nsec/badge-conf-2023/doc/atmega328p-pins.jpeg

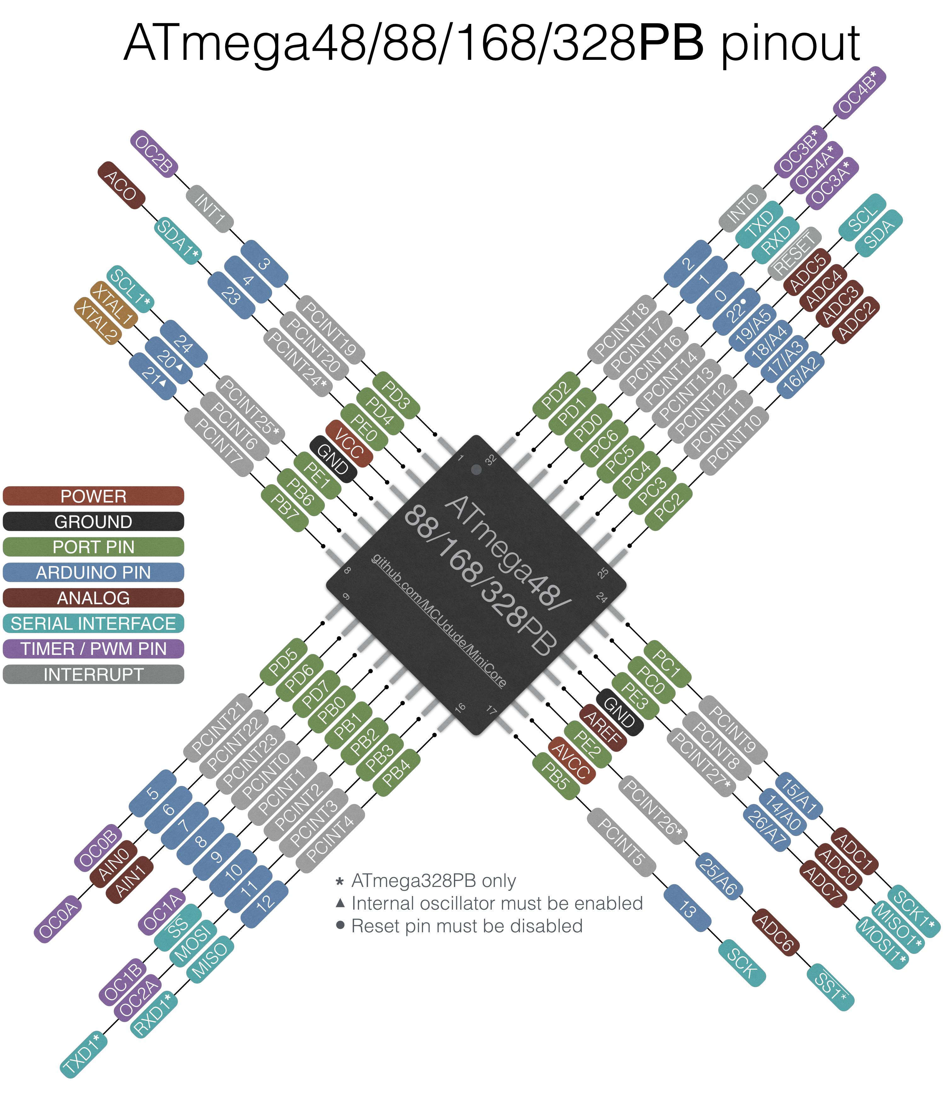
doc/atmega328p-pins.jpeg
