nsec/badge-conf-2023/PCB/badge-conference/gerbers/BOM.xlsx

Value | Designator | Footprint | JLCPCB | DIGIKEY | Comment2
0.1uF | C1, C2, C3, C4, C5, C6, C7, C8, C9, C10, C11, C12, C13, C14, C15, C16, C17, C18, C19, C20 | 0603-CAP | C14663
100K | R7 | 0603-NO | C25803
10K | R2, R8, R9, R16, R17, R18, R19 | 0603-RES | C25804
10uF | C27 | 0805-NO | C440198
1uF | C21, C26 | 0603-NO | C15849
24792479PCB_37P49X52P63_KEY | U6 | 2479PCB_37P49X52P63_KEY |  | 36-2479-ND
330 | R6 | 0603-RES | C23138
5.1K | R1, R5, R13, R14 | 0603-NO | C23186
8/16/20MHz | Q1 | RESONATOR-SMD-1:1 | C22549
AP2112-3.3 | U2 | SOT23-5 | C150742
ATMEGA328PB-AU | U1 | TQFP32-08 | C132230
CH340C | U7 | SOIC127P600X180-16N | C84681
Button | S6, S2, S3, S5, S7, S4 | TACTILE_SWITCH_SMD_5.2MM | C318884
MBR120 | D3, D4 | SOD-123 | C130880
NC | D6, D7 | CHIPLED_0805_NOOUTLINE |  |  | not connected
NC | LED2, LED3 | LED3MM |  |  | not connected
NC | LED7, LED8 | CHIPLED_1206 |  |  | not connected
NC | R3, R4 | 0207/10 |  |  | not connected
NC | R10, R11 | R1206W |  |  | not connected
NC | R12, R15 | 0603-NO |  |  | not connected
OLED | SV3 | MA04-1 |  |  | not connected
PCM12SMTRPCM12SMTR_CNK | U5 | PCM12SMTR_CNK |  | 401-2016-2-ND
RED | D1, D2, D5 | CHIPLED_0805_NOOUTLINE | C84256
RST | S1 | TACTILE_SWITCH_SMD_5.2MM |  |  | not connected
SMF05CT1G | U8 | SOT65P210X110-6N | C558443
SSW-103-22-F-D-VS-K-TRCON3_SSW-D-DUMZ_HDR_SAI | J2 | CON_3x2_FEMALE |  | S5712-ND |  | <<<updated
SYNCIN | SV2 | FE05W |  | 2057-PH1RB-05-UA-ND
SYNCOUT | SV1 | FE05W |  | S5441-ND
TYPE-C-31-M-12 | J3 | HRO_TYPE-C-31-M-12 | C165948
WS2812-2020 | U3, U4, U9, U10, U11, U12, U13, U14, U15, U16, U17, U18, U19, U20, U21, U22 | LED_WS2812-2020 | C965555
SSW-103-22-F-D-VS-K-TRCON3_SSW-D-DUMZ_HDR_SAI | J1 | CON_3x2_MALE |  | 2073-BG050-06A-0-0450-0737-0350-L-D-ND |  | <<<updated
