nsec/badge-conf-2023/PCB/badge-conference/pdf/schematic.pdf

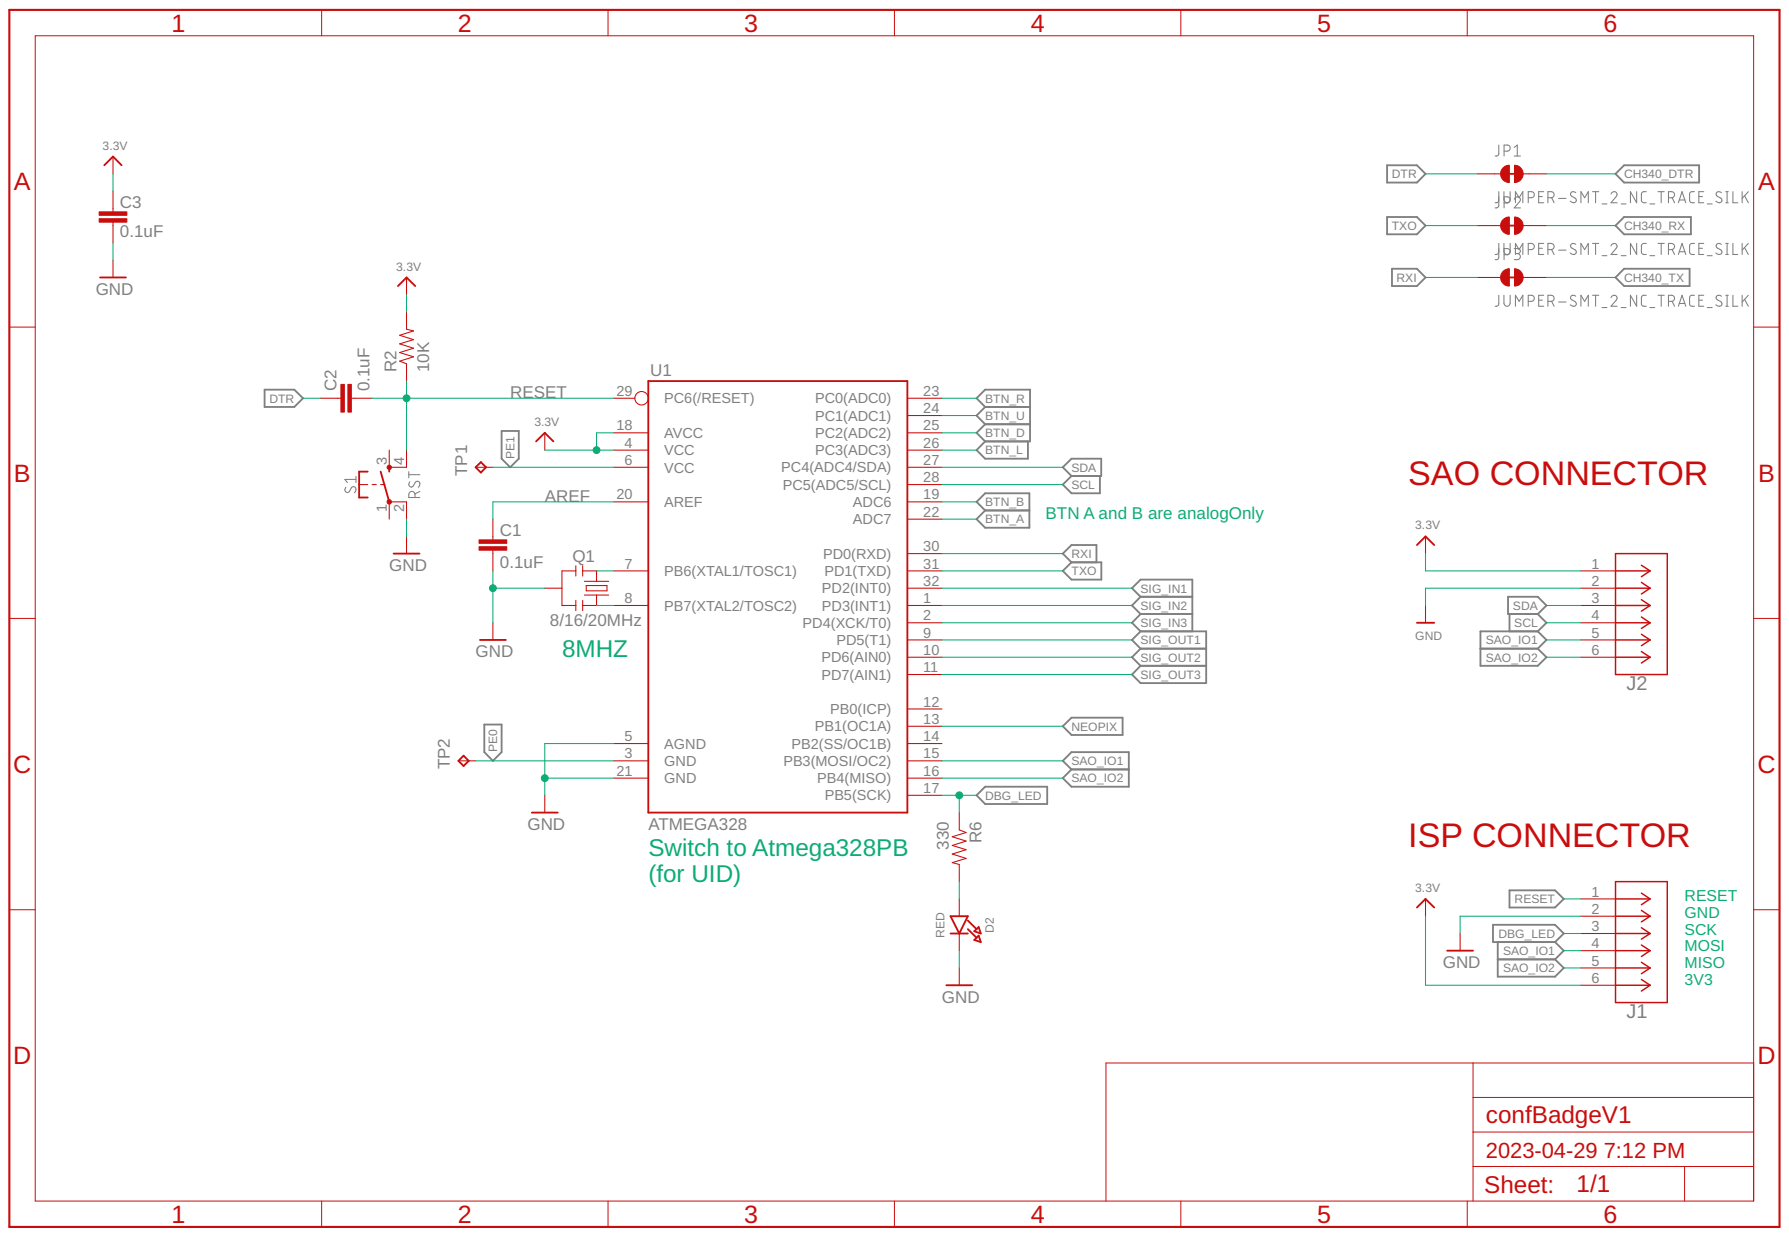
[picture p2: page 1]

SDA
SCL
BTN A and B are analogOnly

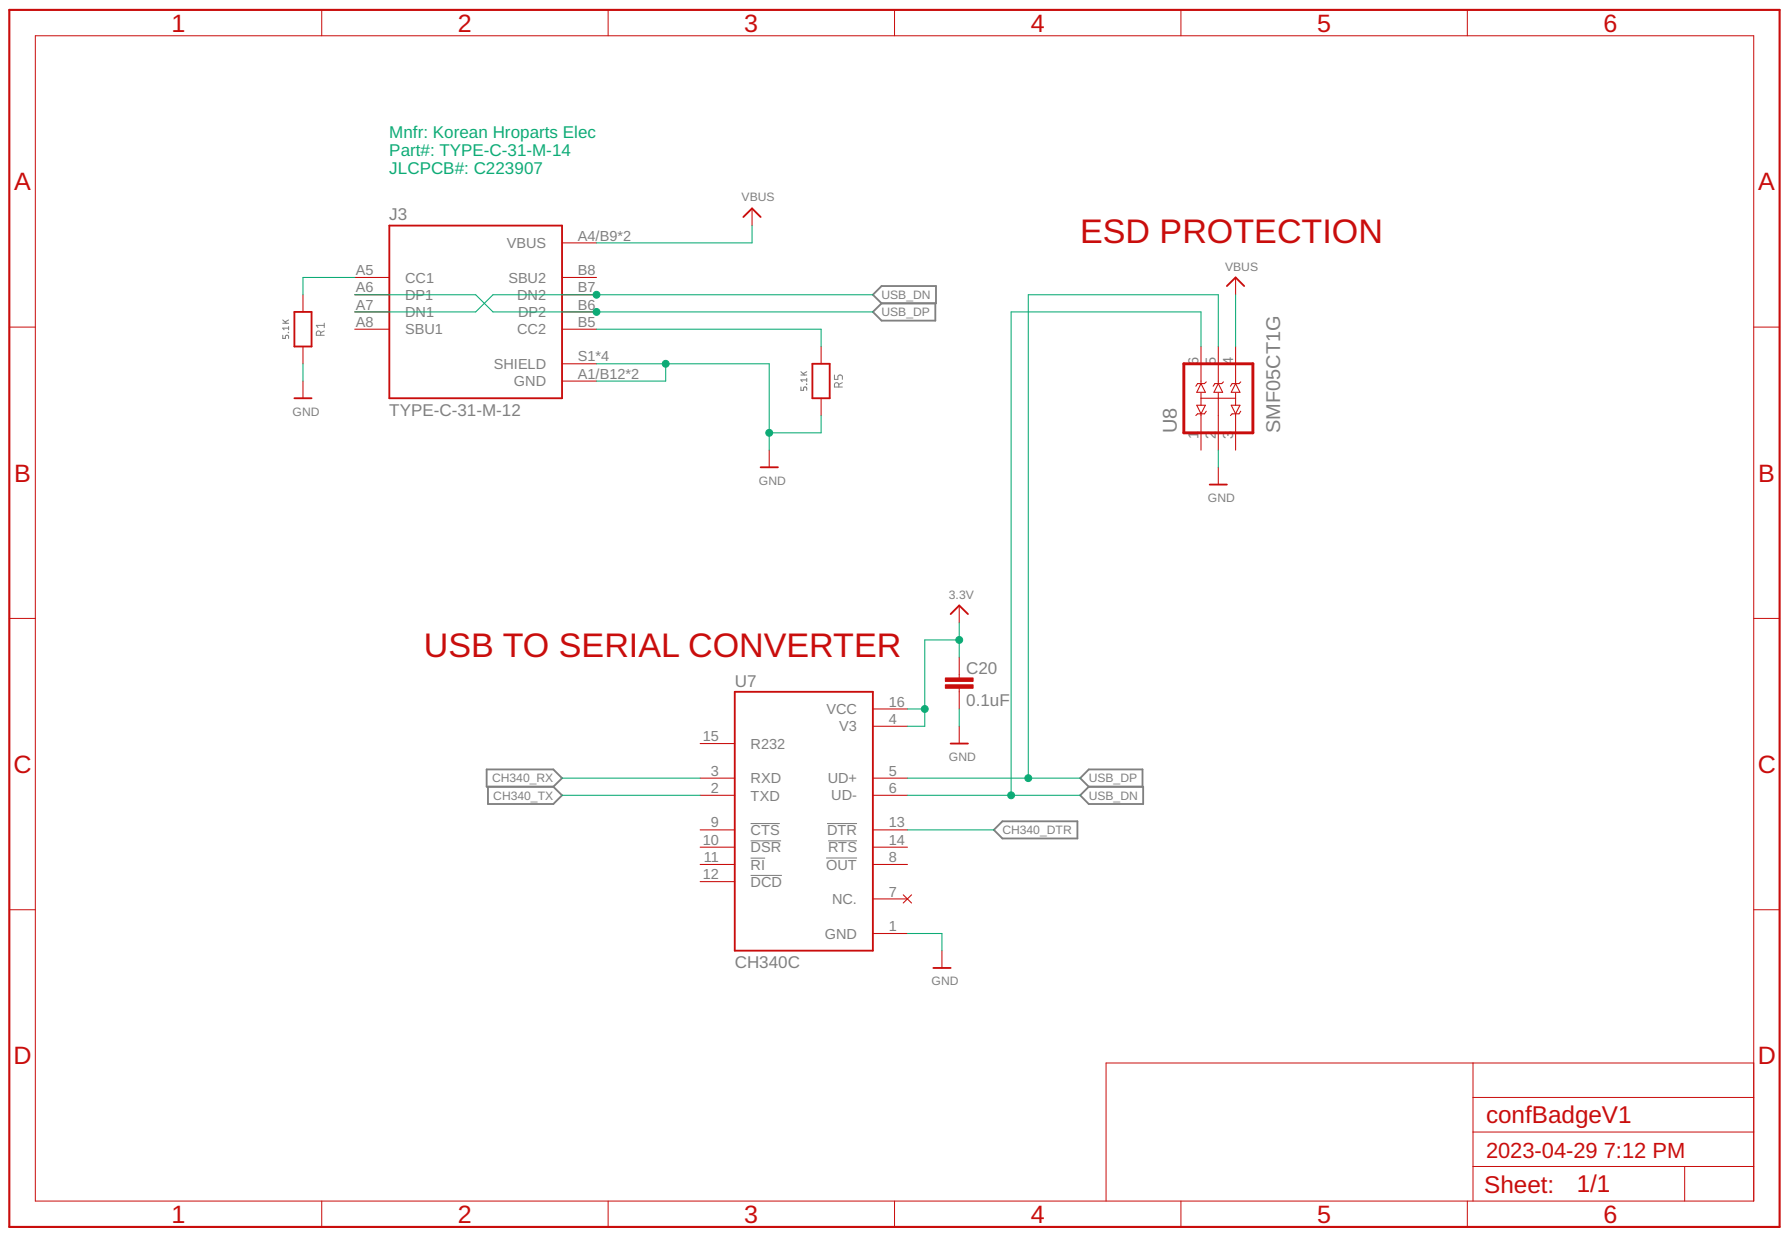
[picture p3: page 2]

Mnfr: Korean Hroparts Elec Part#: TYPE-C-31-M-14

USB TO SERIAL CONVERTER

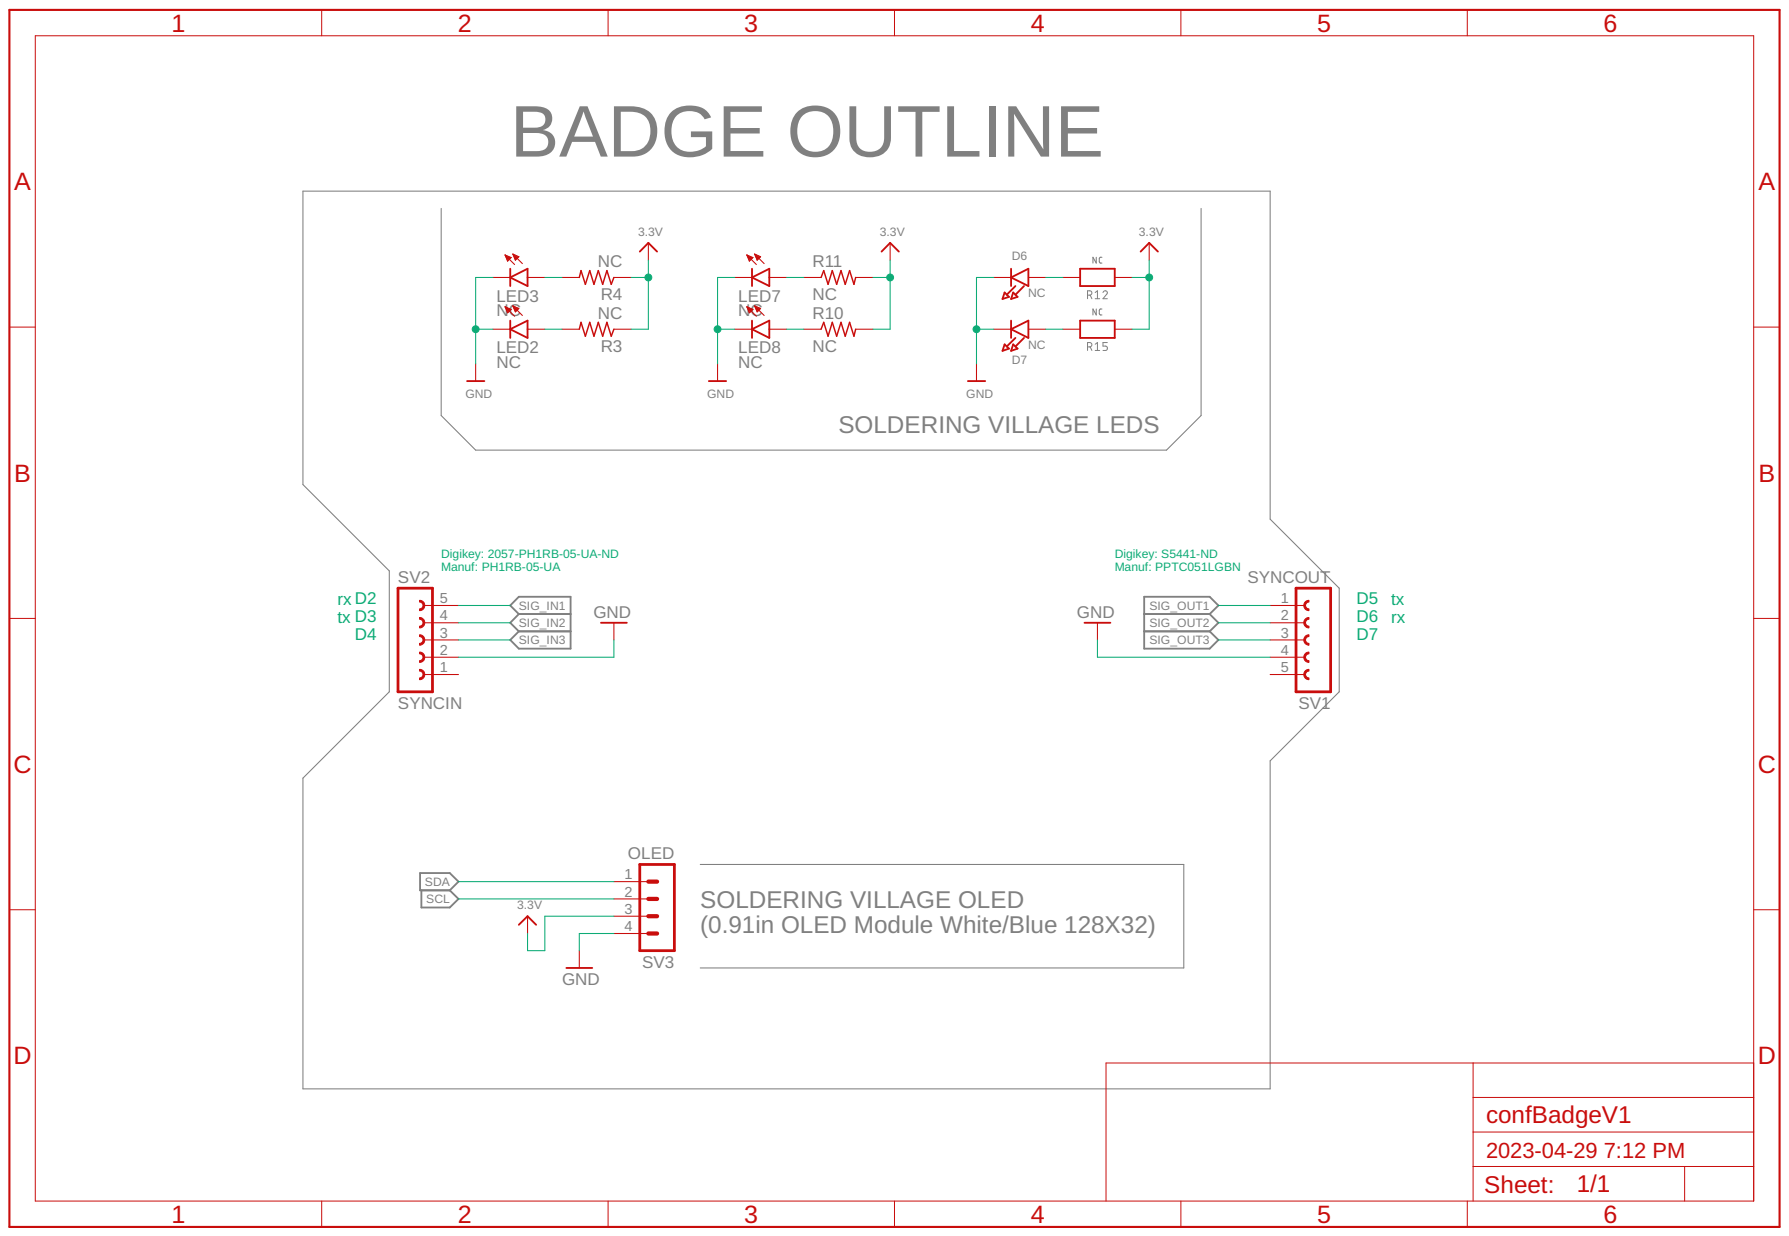
[picture p4: page 3]

SOLDERING VILLAGE OLED
(0.91in OLED Module White/Blue 128X32)

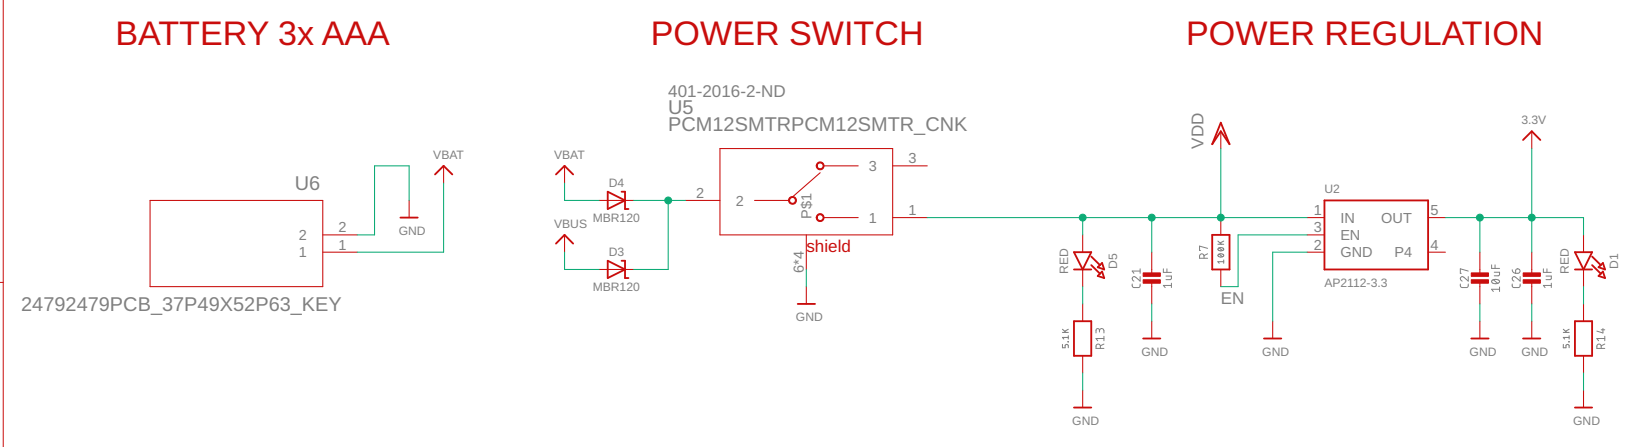
[picture p5: page 4]

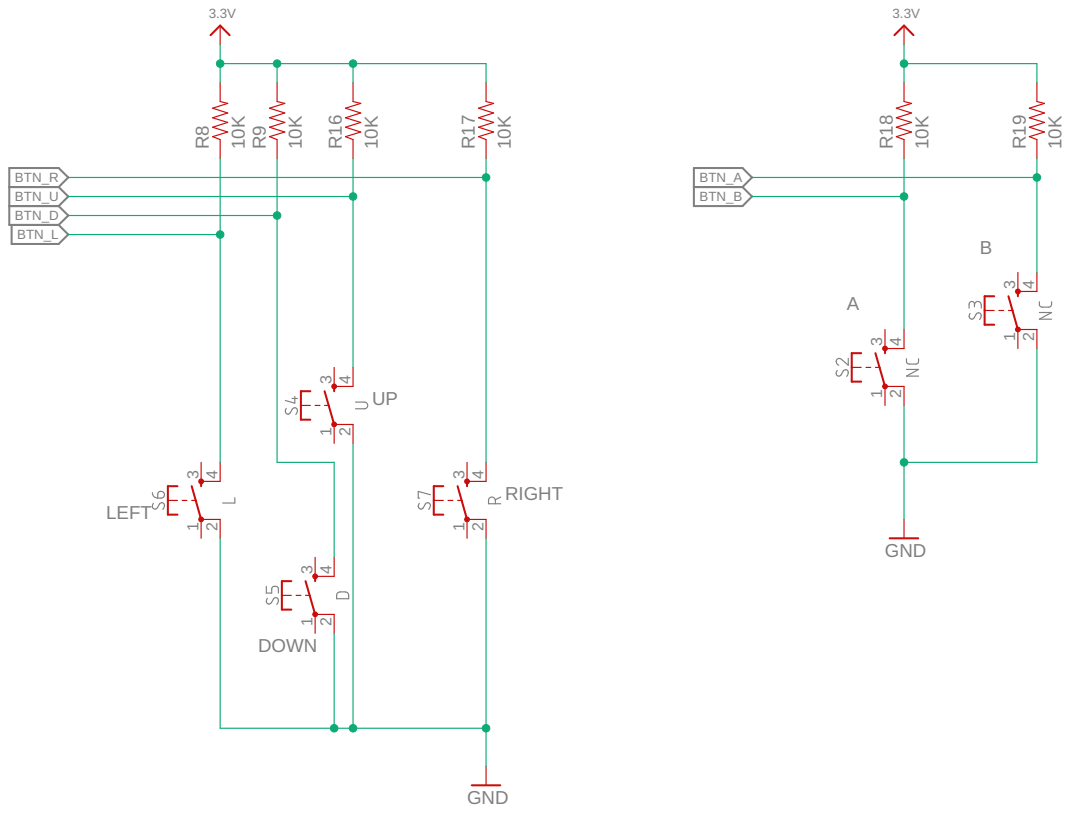
[picture p6: page 5]

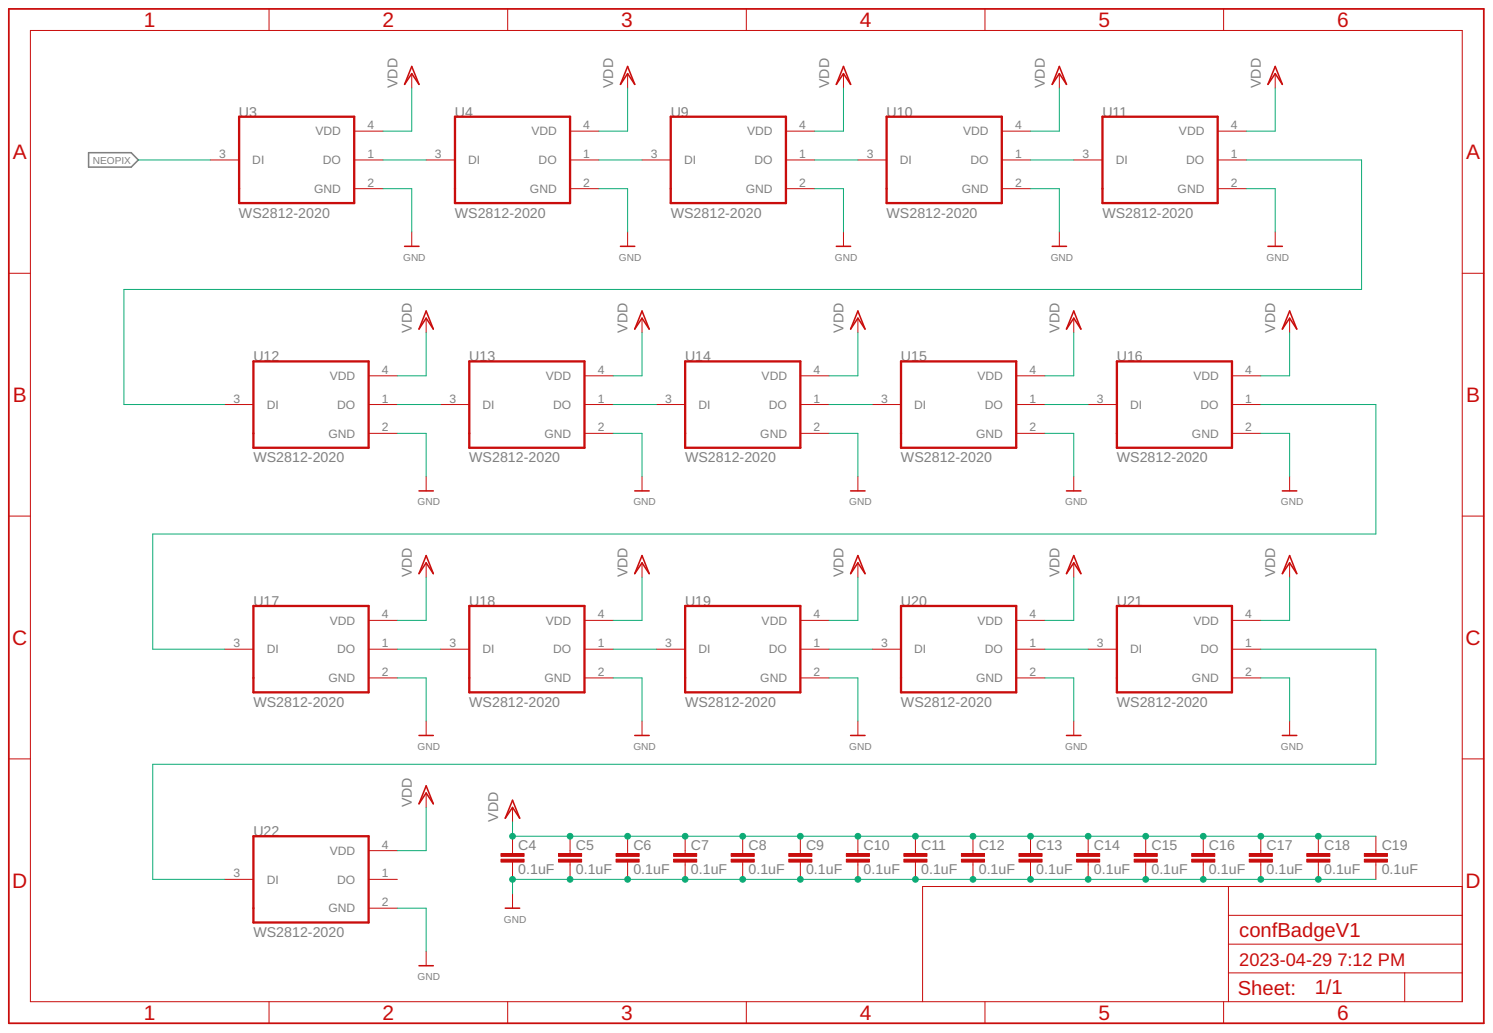
[picture p7: page 6]
