nsec/badge-conf-2023/PCB/badge-conference/pdf/pcbLayout.pdf

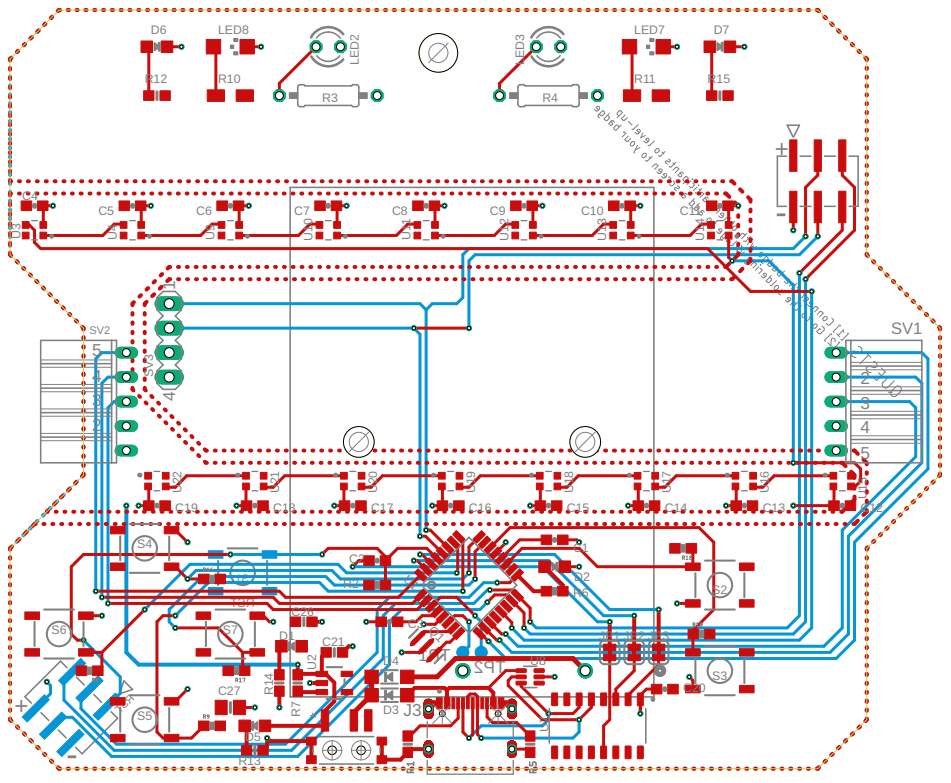
[picture p8: page 1]
