nsec/badge-conf-2023/PCB/badge-conference/confBadgeV1.brd

## EAGLE design PCB/badge-conference/confBadgeV1.brd (2023-05-26)

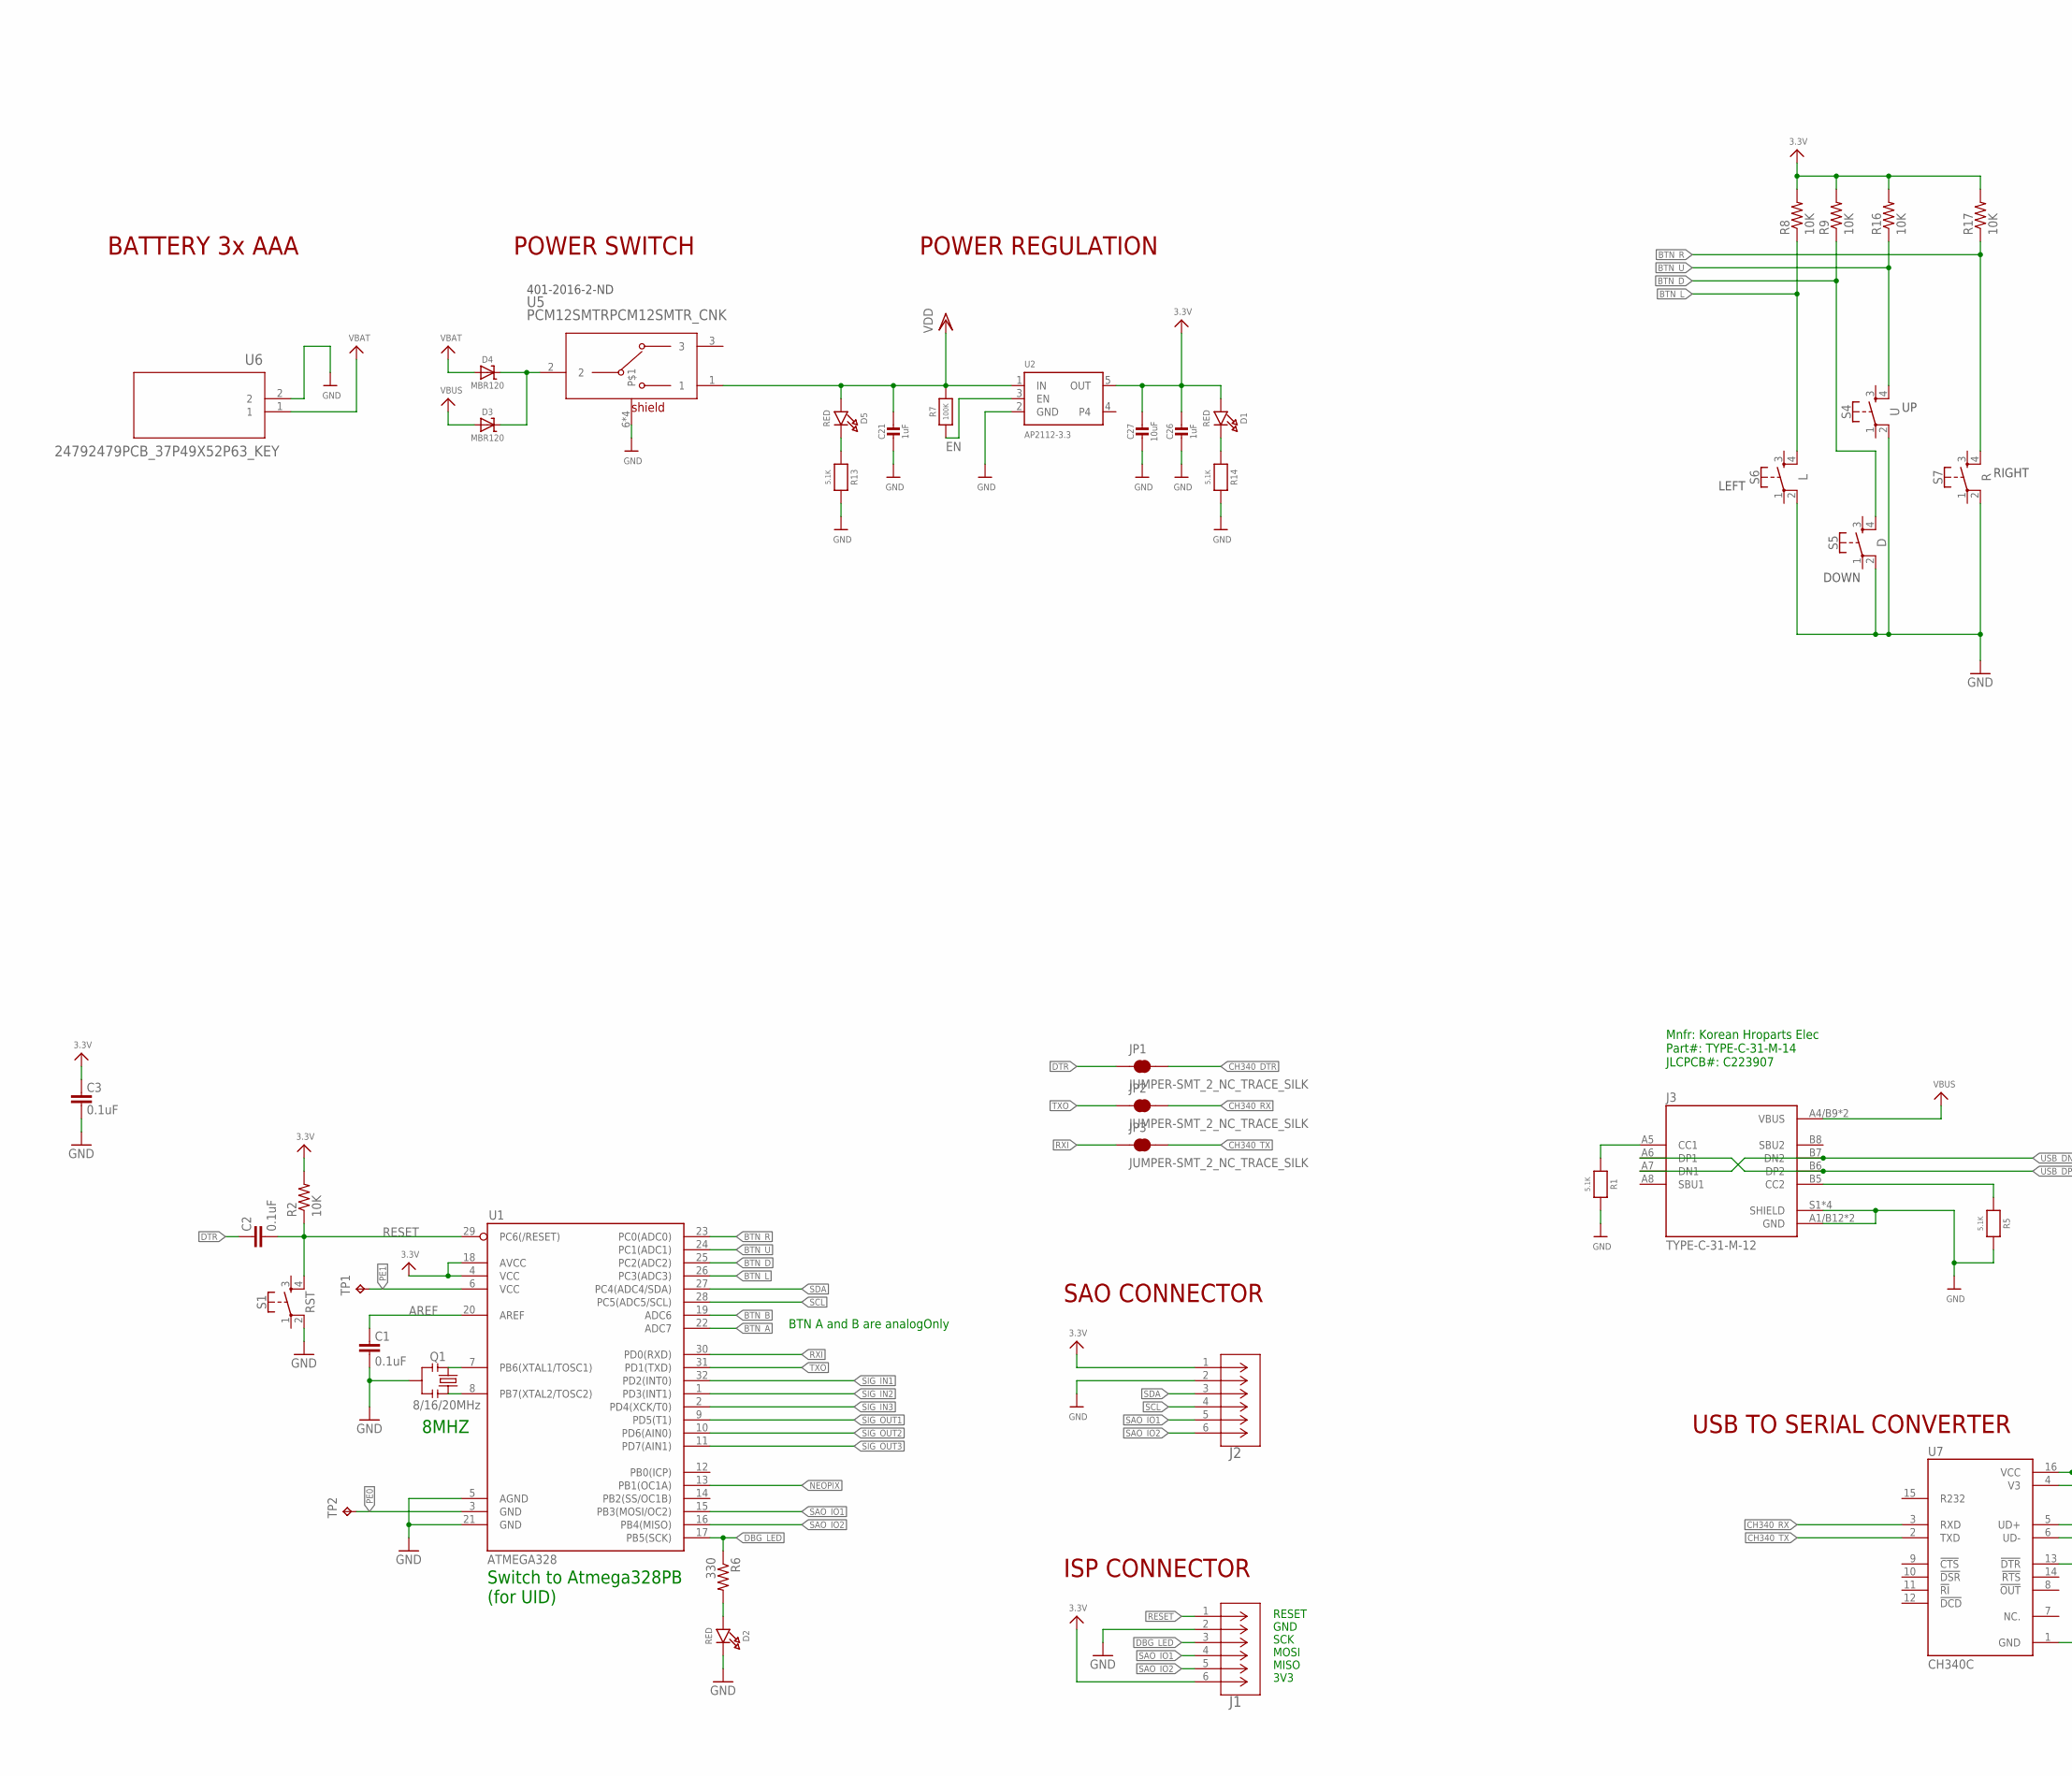
[picture p9: schematic confBadgeV1.sch, part in row 1, column 1]

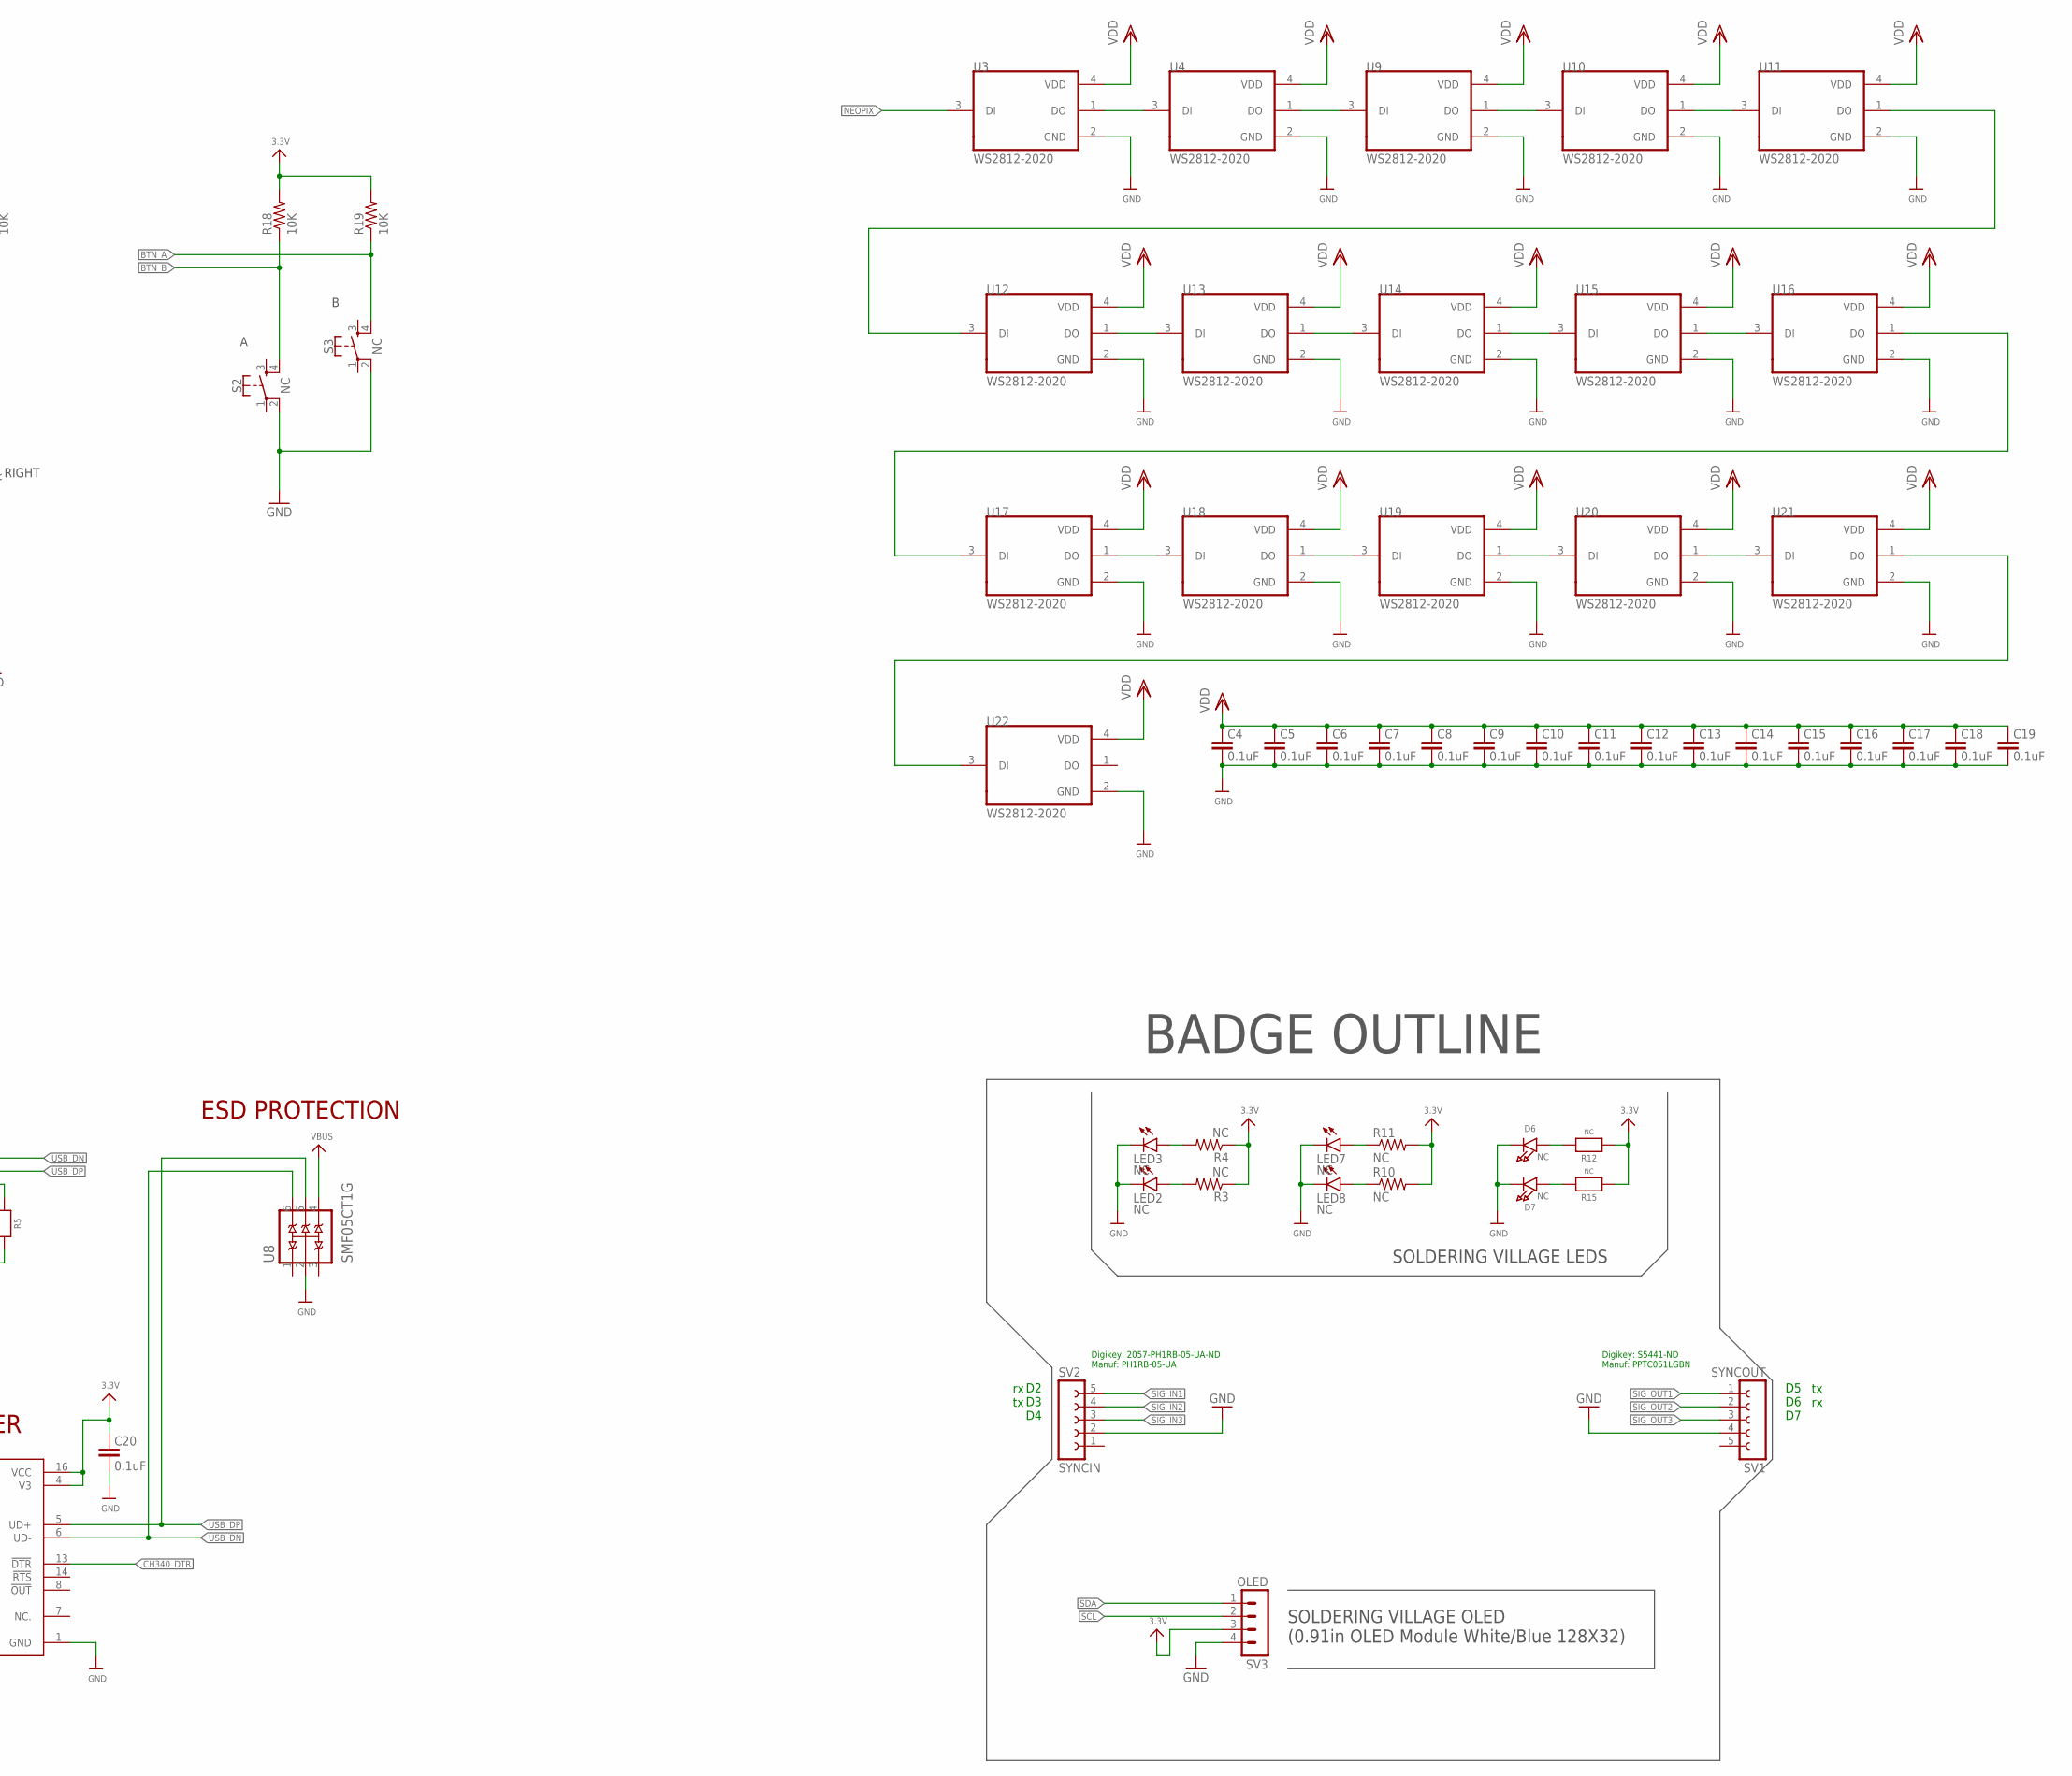
[picture p10: schematic confBadgeV1.sch, part in row 1, column 2]

Parts:
C1, C2, C3, C4, C5, C6, C7, C8, C9, C10, C11, C12, C13, C14, C15, C16, C17, C18, C19, C20: 0.1uF; 0603-CAP
C21, C26: 1uF; 0603-NO
C27: 10uF; 0805-NO
D1, D2, D5: RED; CHIPLED_0805_NOOUTLINE
D3, D4: MBR120; SOD-123
D6, D7: NC; CHIPLED_0805_NOOUTLINE
J1, J2: SSW-103-22-F-D-VS-K-TRCON3_SSW-D-DUMZ_HDR_SAI; CON3_SSW-D-DUMZ_HDR_SAI
J3: TYPE-C-31-M-12; HRO_TYPE-C-31-M-12
JP1, JP2, JP3: JUMPER-SMT_2_NC_TRACE_SILK; SMT-JUMPER_2_NC_TRACE_SILK
LED2, LED3: NC; LED3MM
LED7, LED8: NC; CHIPLED_1206
Q1: 8/16/20MHz; RESONATOR-SMD-1:1
R1, R5, R13, R14: 5.1K; 0603-NO
R2, R8, R9, R16, R17, R18, R19: 10K; 0603-RES
R3, R4: NC; 0207/10
R6: 330; 0603-RES
R7: 100K; 0603-NO
R10, R11: NC; R1206W
R12, R15: NC; 0603-NO
S1: RST; TACTILE_SWITCH_SMD_5.2MM
S2, S3: NC; TACTILE_SWITCH_SMD_5.2MM
S4: U; TACTILE_SWITCH_SMD_5.2MM
S5: D; TACTILE_SWITCH_SMD_5.2MM
S6: L; TACTILE_SWITCH_SMD_5.2MM
S7: R; TACTILE_SWITCH_SMD_5.2MM
SV1: SYNCOUT; FE05W
SV2: SYNCIN; FE05W
SV3: OLED; MA04-1
TP1, TP2: TPB1,27; B1,27
U1: ATMEGA328; TQFP32-08
U2: AP2112-3.3; SOT23-5
U3, U4, U9, U10, U11, U12, U13, U14, U15, U16, U17, U18, U19, U20, U21, U22: WS2812-2020; LED_WS2812-2020
U5: PCM12SMTRPCM12SMTR_CNK; PCM12SMTR_CNK
U6: 24792479PCB_37P49X52P63_KEY; 2479PCB_37P49X52P63_KEY
U7: CH340C; SOIC127P600X180-16N
U8: SMF05CT1G; SOT65P210X110-6N

Connections:
3.3V: C3.2, C20.2, C26.1, C27.1, D1.A, J1.6, J2.1, R2.2, R3.1, R4.1, R8.2, R9.2, R10.2, R11.2, R12.1, R15.1, R16.2, R17.2, R18.2, R19.2, SV3.3, U1.4 (VCC), U1.18 (AVCC), U2.5 (OUT), U7.4 (V3), U7.16 (VCC)
AREF: C1.2, U1.20 (AREF)
BTN_A: R19.1, S3.4, U1.22 (ADC7)
BTN_B: R18.1, S2.4, U1.19 (ADC6)
BTN_D: R9.1, S5.4, U1.25 (PC2(ADC2))
BTN_L: R8.1, S6.4, U1.26 (PC3(ADC3))
BTN_R: R17.1, S7.4, U1.23 (PC0(ADC0))
BTN_U: R16.1, S4.4, U1.24 (PC1(ADC1))
CH340_DTR: JP1.2, U7.13 (!DTR)
CH340_RX: JP2.2, U7.3 (RXD)
CH340_TX: JP3.2, U7.2 (TXD)
DBG_LED: J1.3, R6.1, U1.17 (PB5(SCK))
DTR: C2.2, JP1.1
EN: R7.1, U2.3 (EN)
GND: C1.1, C3.1, C4.1, C5.1, C6.1, C7.1, C8.1, C9.1, C10.1, C11.1, C12.1, C13.1, C14.1, C15.1, C16.1, C17.1, C18.1, C19.1, C20.1, C21.2, C26.2, C27.2, D2.C, D6.C, D7.C, J1.2, J2.2, J3.A1/B12 (GND), J3.B1/A12 (GND), J3.S1 (SHIELD), J3.S2 (SHIELD), J3.S3 (SHIELD), J3.S4 (SHIELD), LED2.K (C), LED3.K (C), LED7.C, LED8.C, Q1.2, R1.2, R5.2, R13.2, R14.2, S1.2, S2.2, S3.2, S4.2, S5.2, S6.2, S7.2, SV1.4, SV2.2, SV3.4, U1.5 (AGND), U1.21 (GND), U2.2 (GND), U3.2 (GND), U4.2 (GND), U5.6, U5.7, U5.8, U5.9, U6.2, U7.1 (GND), U8.2 (A), U9.2 (GND), U10.2 (GND), U11.2 (GND), U12.2 (GND), U13.2 (GND), U14.2 (GND), U15.2 (GND), U16.2 (GND), U17.2 (GND), U18.2 (GND), U19.2 (GND), U20.2 (GND), U21.2 (GND), U22.2 (GND)
unnamed: Q1.3, U1.8 (PB7(XTAL2/TOSC2))
unnamed: Q1.1, U1.7 (PB6(XTAL1/TOSC1))
unnamed: U4.1 (DO), U9.3 (DI)
unnamed: U9.1 (DO), U10.3 (DI)
unnamed: U3.1 (DO), U4.3 (DI)
unnamed: U10.1 (DO), U11.3 (DI)
unnamed: D2.A, R6.2
unnamed: U11.1 (DO), U12.3 (DI)
unnamed: U12.1 (DO), U13.3 (DI)
unnamed: U13.1 (DO), U14.3 (DI)
unnamed: U14.1 (DO), U15.3 (DI)
unnamed: U15.1 (DO), U16.3 (DI)
unnamed: U16.1 (DO), U17.3 (DI)
unnamed: U17.1 (DO), U18.3 (DI)
unnamed: U18.1 (DO), U19.3 (DI)
unnamed: U19.1 (DO), U20.3 (DI)
unnamed: U20.1 (DO), U21.3 (DI)
unnamed: D6.A, R12.2
unnamed: LED2.A, R3.2
unnamed: U21.1 (DO), U22.3 (DI)
unnamed: LED3.A, R4.2
unnamed: D7.A, R15.2
unnamed: LED8.A, R10.1
unnamed: LED7.A, R11.1
unnamed: J3.B5 (CC2), R5.1
unnamed: J3.A5 (CC1), R1.1
unnamed: D3.C, D4.C, U5.2
unnamed: D5.C, R13.1
unnamed: D1.C, R14.1
NEOPIX: U1.13 (PB1(OC1A)), U3.3 (DI)
PE0: TP2.TP, U1.3 (GND)
PE1: TP1.TP, U1.6 (VCC)
RESET: C2.1, J1.1, R2.1, S1.4, U1.29 (PC6(/RESET))
RXI: JP3.1, U1.30 (PD0(RXD))
SAO_IO1: J1.4, J2.5, U1.15 (PB3(MOSI/OC2))
SAO_IO2: J1.5, J2.6, U1.16 (PB4(MISO))
SCL: J2.4, SV3.2, U1.28 (PC5(ADC5/SCL))
SDA: J2.3, SV3.1, U1.27 (PC4(ADC4/SDA))
SIG_IN1: SV2.5, U1.32 (PD2(INT0))
SIG_IN2: SV2.4, U1.1 (PD3(INT1))
SIG_IN3: SV2.3, U1.2 (PD4(XCK/T0))
SIG_OUT1: SV1.1, U1.9 (PD5(T1))
SIG_OUT2: SV1.2, U1.10 (PD6(AIN0))
SIG_OUT3: SV1.3, U1.11 (PD7(AIN1))
TXO: JP2.1, U1.31 (PD1(TXD))
USB_DN: J3.A7 (DN1), J3.B7 (DN2), U7.6 (UD-), U8.6 (C5)
USB_DP: J3.A6 (DP1), J3.B6 (DP2), U7.5 (UD+), U8.5 (C4)
VBAT: D4.A, U6.1
VBUS: D3.A, J3.A4/B9 (VBUS), J3.B4/A9 (VBUS), U8.4 (C3)
VDD: C4.2, C5.2, C6.2, C7.2, C8.2, C9.2, C10.2, C11.2, C12.2, C13.2, C14.2, C15.2, C16.2, C17.2, C18.2, C19.2, C21.1, D5.A, R7.2, U2.1 (IN), U3.4 (VDD), U4.4 (VDD), U5.1, U9.4 (VDD), U10.4 (VDD), U11.4 (VDD), U12.4 (VDD), U13.4 (VDD), U14.4 (VDD), U15.4 (VDD), U16.4 (VDD), U17.4 (VDD), U18.4 (VDD), U19.4 (VDD), U20.4 (VDD), U21.4 (VDD), U22.4 (VDD)

Notes on the sheet:
POWER REGULATION
401-2016-2-ND
POWER SWITCH
BATTERY 3x AAA
DOWN
LEFT
RIGHT
USB TO SERIAL CONVERTER
ESD PROTECTION
BADGE OUTLINE
SOLDERING VILLAGE OLED (0.91in OLED Module White/Blue 128X32)
SOLDERING VILLAGE LEDS
Mnfr: Korean Hroparts Elec Part#: TYPE-C-31-M-14 JLCPCB#: C223907
SAO CONNECTOR
RESET GND SCK MOSI MISO 3V3
ISP CONNECTOR
Digikey: S5441-ND Manuf: PPTC051LGBN
Digikey: 2057-PH1RB-05-UA-ND Manuf: PH1RB-05-UA
Switch to Atmega328PB (for UID)
8MHZ
D2 D3 D4
D5 D6 D7
rx tx
tx rx
BTN A and B are analogOnly

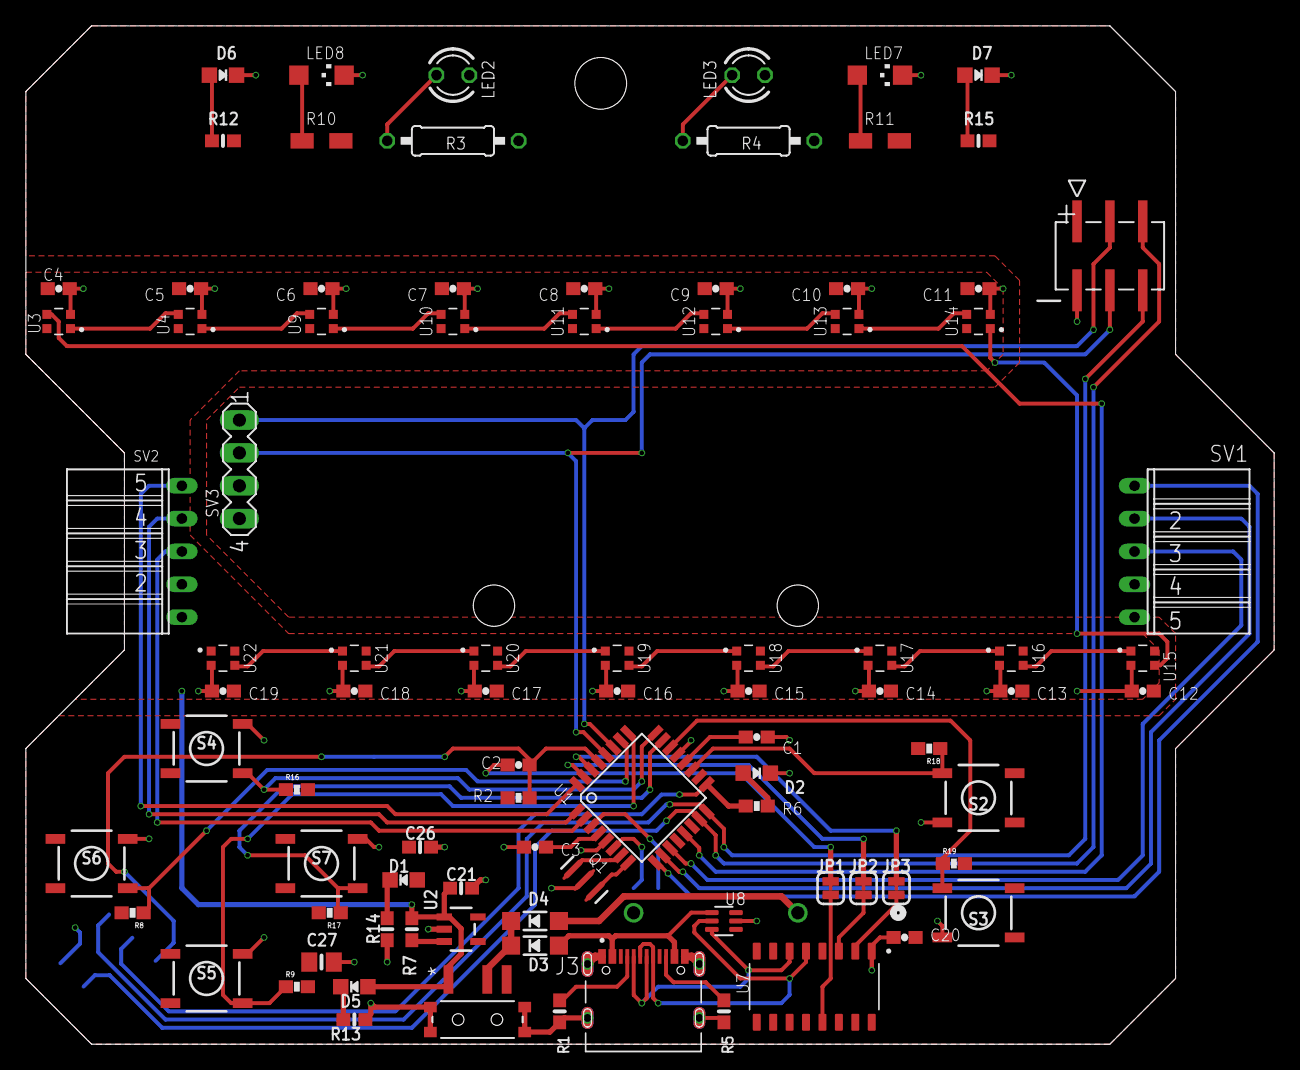
[picture p11: board confBadgeV1.brd from above]

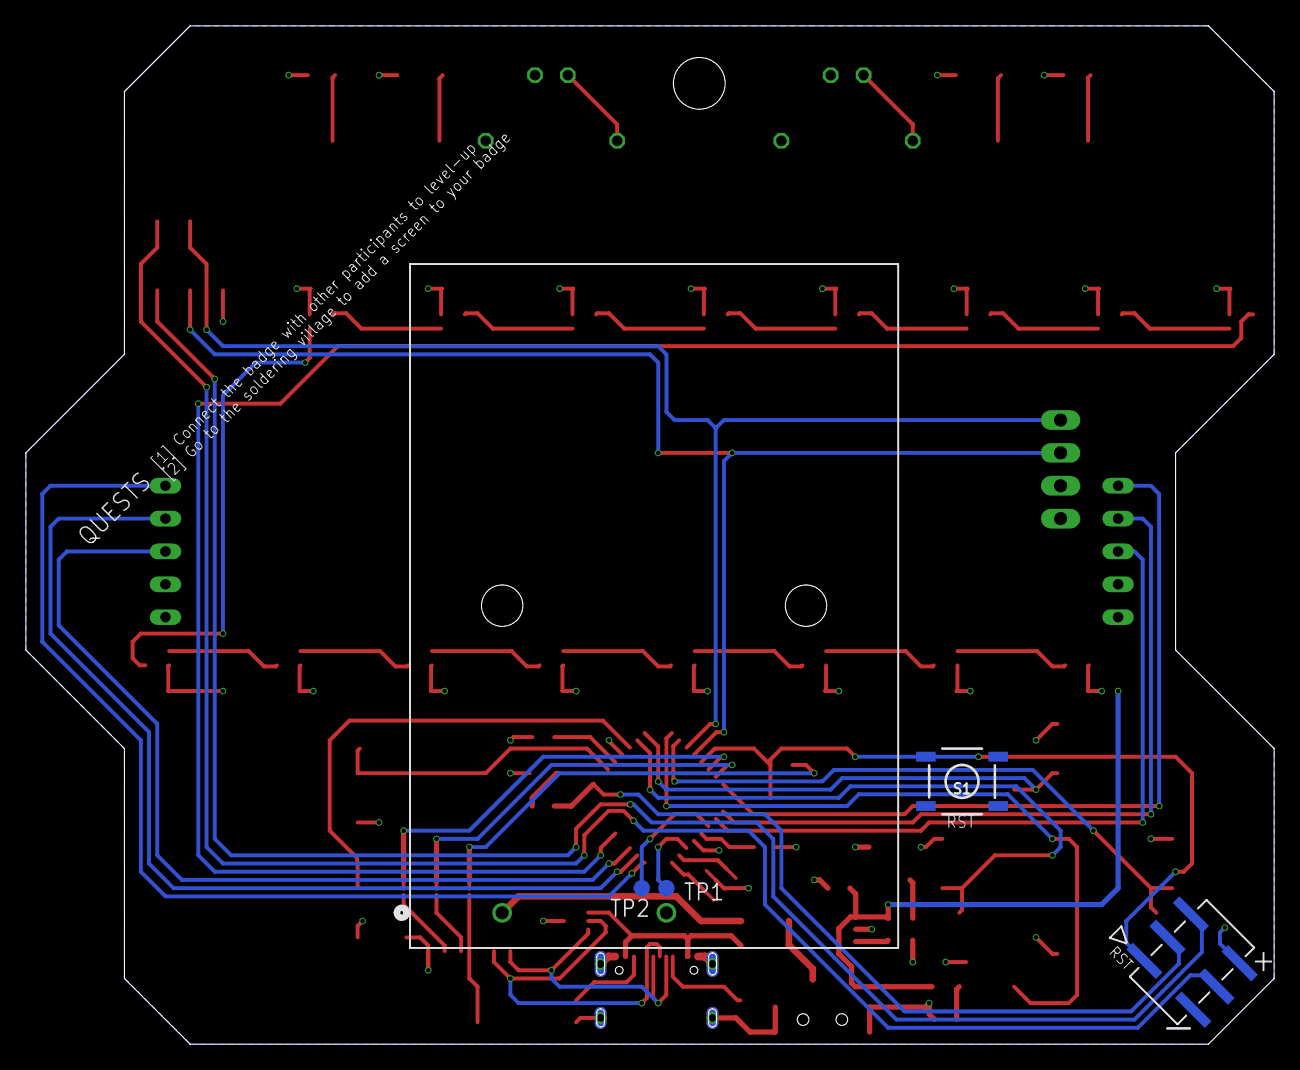
[picture p12: board confBadgeV1.brd from below]

Board: 2 copper layers, 96.5 x 78.7 mm, 94 parts (5 on the bottom side), 65 nets.
