nsec/badge-conf-2023/src/config.hpp

/*
 * SPDX-License-Identifier: MIT
 *
 * Copyright 2023 Jérémie Galarneau <jeremie.galarneau@gmail.com>
 */

#ifndef NSEC_CONFIG_HPP
#define NSEC_CONFIG_HPP

#include "board.hpp"
#include "time.hpp"

#include <stddef.h>
#include <stdint.h>

namespace nsec::config::scheduler {
constexpr unsigned int max_scheduled_task_count = 10;
}

namespace nsec::config::social {
// For animation testing purposes. The social level is 1-based.
constexpr uint8_t initial_level = 1;
constexpr uint8_t max_level = 200;
constexpr uint8_t multiple_badges_discovered_simultaneously_multiplier = 2;
}

namespace nsec::config::user {
constexpr uint8_t name_max_length = 32;
}

namespace nsec::config::splash {
constexpr nsec::scheduling::relative_time_ms splash_screen_wait_time_ms = 2000;
}

namespace nsec::config::button {
constexpr nsec::scheduling::relative_time_ms polling_period_ms = 10;

// How many ticks a button's state must be observed in to trigger.
constexpr uint8_t debounce_ticks = 2;

// Must be multiples of the polling period.
constexpr nsec::scheduling::relative_time_ms button_down_first_repeat_delay_ms = 500;
static_assert(button_down_first_repeat_delay_ms % polling_period_ms == 0);

constexpr nsec::scheduling::relative_time_ms button_down_repeat_delay_ms = 30;
static_assert(button_down_repeat_delay_ms % polling_period_ms == 0);

} // namespace nsec::config::button

namespace nsec::config::display {
constexpr nsec::scheduling::relative_time_ms refresh_period_ms = 16;

constexpr uint8_t menu_font_size = 1;
constexpr uint8_t scroll_font_size = 3;
constexpr uint8_t pairing_font_size = 3;

// Default font.
constexpr uint8_t font_base_width = 6;
constexpr uint8_t font_base_height = 8;

constexpr nsec::scheduling::absolute_time_ms prompt_cycle_time = 2000;

constexpr uint8_t scroll_pixels_per_second = 80;
} // namespace nsec::config::display

namespace nsec::config::communication {
// Size reserved for protocol messages
constexpr size_t protocol_max_message_size = 16;
constexpr unsigned int software_serial_speed = 38400;
/*
* Applications may define messages >= application_message_type_range_begin.
* IDs under this range are reserved by the wire protocol.
*/
constexpr uint8_t application_message_type_range_begin = 10;

constexpr unsigned int connection_sense_pin_left = SIG_L3;
constexpr unsigned int connection_sense_pin_right = SIG_R3;

constexpr unsigned int serial_rx_pin_left = SIG_L1;
constexpr unsigned int serial_tx_pin_left = SIG_L2;
constexpr unsigned int serial_rx_pin_right = SIG_R2;
constexpr unsigned int serial_tx_pin_right = SIG_R1;

constexpr nsec::scheduling::relative_time_ms network_handler_base_period_ms = 60;
constexpr nsec::scheduling::relative_time_ms network_handler_timeout_ms = 10000;
constexpr nsec::scheduling::relative_time_ms network_handler_retransmit_timeout_ms =
	6 * network_handler_base_period_ms;

} // namespace nsec::communication

namespace nsec::config::badge {
constexpr unsigned int pairing_animation_time_per_led_progress_bar_ms = 1000;
} // namespace nsec::badge

#endif // NSEC_CONFIG_HPP
