nsec/badge-conf-2023/src/strip_animator.cpp

/*
 * SPDX-License-Identifier: MIT
 *
 * Copyright 2023 Jérémie Galarneau <jeremie.galarneau@gmail.com>
 */

#include "board.hpp"
#include "globals.hpp"
#include "led/strip_animator.hpp"

namespace nl = nsec::led;
namespace ns = nsec::scheduling;
namespace ng = nsec::g;

#define ARRAY_LENGTH(array) (sizeof(array)/sizeof(*array))

namespace {
constexpr int16_t scaling_factor = 1024;

// Linear interpolation in RGB space: not terrible, not great...
nl::strip_animator::led_color interpolate(const nl::strip_animator::keyframe& origin,
					  const nl::strip_animator::keyframe& destination,
					  uint16_t current_time)
{
	nl::strip_animator::led_color new_color;

	if (current_time >= destination.time) {
		return destination.color;
	}

	const int32_t numerator = (int32_t(current_time) - int32_t(origin.time)) * scaling_factor;
	const int32_t denominator =
		(int32_t(destination.time) - int32_t(origin.time)) * scaling_factor;
	for (uint8_t i = 0; i < sizeof(new_color.components); i++) {
		const int32_t origin_component = origin.color.components[i];
		const int32_t destination_component = destination.color.components[i];
		const int32_t total_diff = destination_component - origin_component;
		const int32_t diff_to_apply = ((total_diff * numerator) / denominator);

		new_color.components[i] = uint8_t(origin_component + diff_to_apply);
	}

	return new_color;
}

nl::strip_animator::keyframe keyframe_from_flash(const nl::strip_animator::keyframe *src_keyframe)
{
	const auto r = pgm_read_byte(&src_keyframe->color.r());
	const auto g = pgm_read_byte(&src_keyframe->color.g());
	const auto b = pgm_read_byte(&src_keyframe->color.b());

	return { { r, g, b }, pgm_read_word(&src_keyframe->time) };
}

} // namespace

namespace keyframes {
const nl::strip_animator::keyframe PROGMEM red_to_green_progress_bar_keyframe_template[] = {
	// red
	{ { 100, 20, 0 }, 0 },
	{ { 0, 0, 0 }, nsec::config::badge::pairing_animation_time_per_led_progress_bar_ms / 2 },
	// green <- beginning of loop
	{ { 0, 255, 0 }, nsec::config::badge::pairing_animation_time_per_led_progress_bar_ms },
	// dimmed green to green loop
	{ { 48, 120, 19 },
	  nsec::config::badge::pairing_animation_time_per_led_progress_bar_ms * 2 },
	{ { 0, 255, 0 }, nsec::config::badge::pairing_animation_time_per_led_progress_bar_ms * 3 },
};

const nl::strip_animator::keyframe PROGMEM happy_clown_barf_keyframes[] = {
	{ { 0, 0, 0 }, 0 },
	{ { 161, 255, 181 }, 100 },
	{ { 255, 128, 140 }, 200 },
	{ { 255, 188, 110 }, 300 },
	{ { 255, 255, 110 }, 400 },
	{ { 110, 192, 255 }, 500 },
	{ { 161, 255, 181 }, 600 },
};

const nl::strip_animator::keyframe PROGMEM no_new_friends_keyframes[] = {
	{ { 0, 0, 0 }, 0 },
	{ { 255, 0, 0 }, 200 },
	{ { 0, 0, 0 }, 400 },
	{ { 255, 0, 0 }, 600 },
};


namespace shooting_star {
// Colors evoking a tungten flash
const nl::strip_animator::keyframe PROGMEM shooting_star_tungsten_keyframes[] = {
	{ { 0, 0, 0 }, 0 }, // black
	{ { 255, 255, 255 }, 100 }, // white
	{ { 180, 0, 200 }, 400 }, // violet
	{ { 70, 0, 0 }, 900 }, // red
	{ { 0, 0, 0 }, 1500 }, // black
	{ { 0, 0, 0 }, 5000 }, // maintain black
};

const nl::strip_animator::keyframe PROGMEM shooting_star_2_keyframes[] = {
	{ { 0, 255, 159 }, 0 },
	{ { 0, 138, 198 }, 900 },
	{ { 0, 0, 0 }, 1500 },
	{ { 0, 0, 0 }, 5000 },
};

const nl::strip_animator::keyframe PROGMEM shooting_star_3_keyframes[] = {
	{ { 123,179,255 }, 0 },
	{ { 232,106,240 }, 500 },
	{ { 158,55,159 }, 1000 },
	{ { 0, 0, 0 }, 1300 },
	{ { 0, 0, 0 }, 5000 },
};

const nl::strip_animator::keyframe PROGMEM shooting_star_4_keyframes[] = {
	{ { 115,205,186 }, 0 },
	{ { 198,240,234 }, 500 },
	{ { 79,145,62 }, 1000 },
	{ { 0, 0, 0 }, 1300 },
	{ { 0, 0, 0 }, 5000 },
};

const nl::strip_animator::keyframe PROGMEM shooting_star_5_keyframes[] = {
	{ { 255, 128, 0 }, 0 },
	{ { 200, 128, 0 }, 600 },
	{ { 0, 0, 0 }, 1300 },
	{ { 0, 0, 0 }, 5000 },
};

const nl::strip_animator::keyframe PROGMEM shooting_star_6_keyframes[] = {
	{ { 0, 255, 128 }, 0 },
	{ { 255,255, 51 }, 500 },
	{ { 255,153, 51 }, 1000 },
	{ { 0, 0, 0 }, 1300 },
	{ { 0, 0, 0 }, 5000 },
};

const nl::strip_animator::keyframe PROGMEM shooting_star_7_keyframes[] = {
	{ { 255,0,255 }, 0 },
	{ { 127,0,255 }, 500 },
	{ { 0,0,32 }, 1000 },
	{ { 0, 0, 0 }, 1300 },
	{ { 0, 0, 0 }, 5000 },
};

const nl::strip_animator::keyframe PROGMEM shooting_star_8_keyframes[] = {
	{ { 0, 0, 0 }, 0 },
	{ { 255, 204, 204 }, 100 },
	{ { 51, 153, 255 }, 400 },
	{ { 76, 0, 153 }, 900 },
	{ { 0, 0, 0 }, 1500 },
	{ { 0, 0, 0 }, 5000 },
};

struct shooting_star_parameters {
	uint8_t shooting_star_count;
	uint16_t delay_advance_ms;
	const nl::strip_animator::keyframe *keyframes;
	uint8_t keyframe_count;
};

const shooting_star_parameters PROGMEM params[] = {
	// white-violet-red, slow
	{ 1, 90, shooting_star_tungsten_keyframes, ARRAY_LENGTH(shooting_star_tungsten_keyframes) },
	{ 2, 2*90, shooting_star_tungsten_keyframes, ARRAY_LENGTH(shooting_star_tungsten_keyframes) },
	{ 4, 3*90, shooting_star_tungsten_keyframes, ARRAY_LENGTH(shooting_star_tungsten_keyframes) },
	{ 8, 4*90, shooting_star_tungsten_keyframes, ARRAY_LENGTH(shooting_star_tungsten_keyframes) },
	// cyan-blue, slow
	{ 1, 90, shooting_star_2_keyframes, ARRAY_LENGTH(shooting_star_2_keyframes) },
	{ 2, 2*90, shooting_star_2_keyframes, ARRAY_LENGTH(shooting_star_2_keyframes) },
	{ 4, 3*90, shooting_star_2_keyframes, ARRAY_LENGTH(shooting_star_2_keyframes) },
	{ 8, 4*90, shooting_star_2_keyframes, ARRAY_LENGTH(shooting_star_2_keyframes) },
	// violet-blue, fast
	{ 1, 40, shooting_star_3_keyframes, ARRAY_LENGTH(shooting_star_3_keyframes) },
	{ 2, 2*40, shooting_star_3_keyframes, ARRAY_LENGTH(shooting_star_3_keyframes) },
	{ 4, 3*40, shooting_star_3_keyframes, ARRAY_LENGTH(shooting_star_3_keyframes) },
	{ 8, 4*40, shooting_star_3_keyframes, ARRAY_LENGTH(shooting_star_3_keyframes) },
	// aqua-green , fast
	{ 1, 40, shooting_star_4_keyframes, ARRAY_LENGTH(shooting_star_4_keyframes) },
	{ 2, 2*40, shooting_star_4_keyframes, ARRAY_LENGTH(shooting_star_4_keyframes) },
	{ 4, 3*40, shooting_star_4_keyframes, ARRAY_LENGTH(shooting_star_4_keyframes) },
	{ 8, 4*40, shooting_star_4_keyframes, ARRAY_LENGTH(shooting_star_4_keyframes) },
	// orange , slow
	{ 1, 90, shooting_star_5_keyframes, ARRAY_LENGTH(shooting_star_5_keyframes) },
	{ 2, 2*90, shooting_star_5_keyframes, ARRAY_LENGTH(shooting_star_5_keyframes) },
	{ 4, 3*90, shooting_star_5_keyframes, ARRAY_LENGTH(shooting_star_5_keyframes) },
	{ 8, 4*90, shooting_star_5_keyframes, ARRAY_LENGTH(shooting_star_5_keyframes) },
	// green to orange , slow
	{ 1, 90, shooting_star_6_keyframes, ARRAY_LENGTH(shooting_star_6_keyframes) },
	{ 2, 2*90, shooting_star_6_keyframes, ARRAY_LENGTH(shooting_star_6_keyframes) },
	{ 4, 3*90, shooting_star_6_keyframes, ARRAY_LENGTH(shooting_star_6_keyframes) },
	{ 8, 4*90, shooting_star_6_keyframes, ARRAY_LENGTH(shooting_star_6_keyframes) },
	// violet to blue , slow
	{ 1, 90, shooting_star_7_keyframes, ARRAY_LENGTH(shooting_star_7_keyframes) },
	{ 2, 2*90, shooting_star_7_keyframes, ARRAY_LENGTH(shooting_star_7_keyframes) },
	{ 4, 3*90, shooting_star_7_keyframes, ARRAY_LENGTH(shooting_star_7_keyframes) },
	{ 8, 4*90, shooting_star_7_keyframes, ARRAY_LENGTH(shooting_star_7_keyframes) },
	// white to blue, slow
	{ 1, 90, shooting_star_8_keyframes, ARRAY_LENGTH(shooting_star_8_keyframes) },
	{ 2, 2*90, shooting_star_8_keyframes, ARRAY_LENGTH(shooting_star_8_keyframes) },
	{ 4, 3*90, shooting_star_8_keyframes, ARRAY_LENGTH(shooting_star_8_keyframes) },
	{ 8, 4*90, shooting_star_8_keyframes, ARRAY_LENGTH(shooting_star_8_keyframes) },
};

shooting_star_parameters shooting_star_parameters_from_flash(const shooting_star_parameters* params)
{
	shooting_star_parameters value;

	value.shooting_star_count = pgm_read_byte(&params->shooting_star_count);
	value.delay_advance_ms = pgm_read_word(&params->delay_advance_ms);

	static_assert(sizeof(value.keyframes) == sizeof(uint16_t));
	value.keyframes = reinterpret_cast<const nl::strip_animator::keyframe*>(pgm_read_word(&params->keyframes));
	value.keyframe_count = pgm_read_byte(&params->keyframe_count);

	return value;
}
} // namespace shooting_star

namespace color_cycle {
struct color_cycle_parameters {
	uint16_t active_pattern;
	uint8_t cycle_offset;
	uint8_t keyframe_count;
	const nl::strip_animator::keyframe *keyframes;
};

// Dark wave synth
const nl::strip_animator::keyframe PROGMEM color_cycle_1_keyframes[] = {
	{ { 0,0,0 }, 0 },
	{ { 255,73,219 }, 1 },
	{ { 28,28,62 }, 1000 },
	{ { 50,240,255 }, 2000 },
	{ { 255,129,50 }, 3000 },
	{ { 90,52,123 }, 4000 },
	{ { 255,73,219 }, 5000 },
};

// red-white
const nl::strip_animator::keyframe PROGMEM color_cycle_2_keyframes[] = {
	{ { 0,0,0 }, 0 },
	{ { 255,255,255 }, 1 },
	{ { 255,0,0 }, 1000 },
	{ { 255,255,255 }, 2000 },
};

// pastel rainbow
const nl::strip_animator::keyframe PROGMEM color_cycle_3_keyframes[] = {
	{ { 0,0,0 }, 0 },
	{ { 255,179,186 }, 1 },
	{ { 255,223,186 }, 1000 },
	{ { 255,255,186 }, 2000 },
	{ { 186,255,201 }, 3000 },
	{ { 186,225,255 }, 4000 },
	{ { 255,179,186 }, 5000 },
};

// orange breathing
const nl::strip_animator::keyframe PROGMEM color_cycle_orange_breathing_keyframes[] = {
	{ { 0,0,0 }, 0 },
	{ { 153,76,0 }, 1 },
	{ { 255,178,102 }, 2000 },
	{ { 153,76,0 }, 4000 },
};

const nl::strip_animator::keyframe PROGMEM color_cycle_red_breathing_keyframes[] = {
	{ { 0,0,0 }, 0 },
	{ { 153,0,0 }, 1 },
	{ { 255,102,102 }, 2000 },
	{ { 153,0,0 }, 4000 },
};

const nl::strip_animator::keyframe PROGMEM color_cycle_yellow_breathing_keyframes[] = {
	{ { 0,0,0 }, 0 },
	{ { 153,153,0 }, 1 },
	{ { 255,255,102 }, 2000 },
	{ { 153,153,0 }, 4000 },
};

const nl::strip_animator::keyframe PROGMEM color_cycle_green_breathing_keyframes[] = {
	{ { 0,0,0 }, 0 },
	{ { 0,153,0 }, 1 },
	{ { 102,255,102 }, 2000 },
	{ { 0,153,0 }, 4000 },
};

const nl::strip_animator::keyframe PROGMEM color_cycle_cyan_breathing_keyframes[] = {
	{ { 0,0,0 }, 0 },
	{ { 0,153,153 }, 1 },
	{ { 102,255,255 }, 2000 },
	{ { 0,153,153 }, 4000 },
};

const nl::strip_animator::keyframe PROGMEM color_cycle_blue_breathing_keyframes[] = {
	{ { 0,0,0 }, 0 },
	{ { 102,102,255 }, 1 },
	{ { 0,0,153 }, 2000 },
	{ { 102,102,255 }, 4000 },
};

const nl::strip_animator::keyframe PROGMEM color_cycle_violet_breathing_keyframes[] = {
	{ { 0,0,0 }, 0 },
	{ { 76,0,153 }, 1 },
	{ { 178,102,255 }, 2000 },
	{ { 76,0,153 }, 4000 },
};

const nl::strip_animator::keyframe PROGMEM color_cycle_pink_breathing_keyframes[] = {
	{ { 0,0,0 }, 0 },
	{ { 153,0,153 }, 1 },
	{ { 255,102,255 }, 2000 },
	{ { 153,0,153 }, 4000 },
};

const nl::strip_animator::keyframe PROGMEM color_cycle_white_breathing_keyframes[] = {
	{ { 0,0,0 }, 0 },
	{ { 153,76,0 }, 1 },
	{ { 255,178,102 }, 2000 },
	{ { 153,76,0 }, 4000 },
};

// Magenta-blue heartbeat
const nl::strip_animator::keyframe PROGMEM color_cycle_magenta_blue_hb_keyframes[] = {
	{ { 0,0,0 }, 0 },
	{ { 0,0,0 }, 1 },
	{ { 0,0,0 }, 200 },
	{ { 255,50,255 }, 300 },
	{ { 20,20,20 }, 400 },
	{ { 20,20,20 }, 500 },
	{ { 25,25,127 }, 600 },
	{ { 0,0,0 }, 800 },
	{ { 0,0,0 }, 1200 },
};

const nl::strip_animator::keyframe PROGMEM color_cycle_green_pink_hb_keyframes[] = {
	{ { 0,0,0 }, 0 },
	{ { 0,0,0 }, 1 },
	{ { 0,0,0 }, 200 },
	{ { 50,200,50 }, 300 },
	{ { 10,10,10 }, 400 },
	{ { 10,10,10 }, 500 },
	{ { 200,50,170 }, 600 },
	{ { 0,0,0 }, 800 },
	{ { 0,0,0 }, 1200 },
};

// purple-white
const nl::strip_animator::keyframe PROGMEM color_cycle_4_keyframes[] = {
	{ { 0,0,0 }, 0 },
	{ { 255,255,255 }, 1 },
	{ { 101, 78, 146 }, 1000 },
	{ { 255,255,255 }, 2000 },
};

// yellow-white
const nl::strip_animator::keyframe PROGMEM color_cycle_5_keyframes[] = {
	{ { 0,0,0 }, 0 },
	{ { 255,255,255 }, 1 },
	{ { 249, 245, 75 }, 1000 },
	{ { 255,255,255 }, 2000 },
};

// cyan-white
const nl::strip_animator::keyframe PROGMEM color_cycle_6_keyframes[] = {
	{ { 0,0,0 }, 0 },
	{ { 255,255,255 }, 1 },
	{ { 139, 245, 250 }, 1000 },
	{ { 255,255,255 }, 2000 },
};

// orange-white
const nl::strip_animator::keyframe PROGMEM color_cycle_7_keyframes[] = {
	{ { 0,0,0 }, 0 },
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

	{ 0xFFFF, 0, ARRAY_LENGTH(color_cycle_9_keyframes), color_cycle_9_keyframes },
	{ 0xFFFF, 10, ARRAY_LENGTH(color_cycle_9_keyframes), color_cycle_9_keyframes },
	{ 0b1010101010101010, 10, ARRAY_LENGTH(color_cycle_9_keyframes), color_cycle_9_keyframes },

	{ 0xFFFF, 0, ARRAY_LENGTH(color_cycle_orange_breathing_keyframes), color_cycle_orange_breathing_keyframes },
	{ 0xFFFF, 60, ARRAY_LENGTH(color_cycle_orange_breathing_keyframes), color_cycle_orange_breathing_keyframes },
	{ 0b1010101010101010, 60, ARRAY_LENGTH(color_cycle_orange_breathing_keyframes), color_cycle_orange_breathing_keyframes },

	{ 0xFFFF, 0, ARRAY_LENGTH(color_cycle_red_breathing_keyframes), color_cycle_red_breathing_keyframes },
	{ 0xFFFF, 60, ARRAY_LENGTH(color_cycle_red_breathing_keyframes), color_cycle_red_breathing_keyframes },
	{ 0b1010101010101010, 60, ARRAY_LENGTH(color_cycle_red_breathing_keyframes), color_cycle_red_breathing_keyframes },

	{ 0xFFFF, 0, ARRAY_LENGTH(color_cycle_yellow_breathing_keyframes), color_cycle_yellow_breathing_keyframes },
	{ 0xFFFF, 60, ARRAY_LENGTH(color_cycle_yellow_breathing_keyframes), color_cycle_yellow_breathing_keyframes },
	{ 0b1010101010101010, 60, ARRAY_LENGTH(color_cycle_yellow_breathing_keyframes), color_cycle_yellow_breathing_keyframes },

	{ 0xFFFF, 0, ARRAY_LENGTH(color_cycle_green_breathing_keyframes), color_cycle_green_breathing_keyframes },
	{ 0xFFFF, 60, ARRAY_LENGTH(color_cycle_green_breathing_keyframes), color_cycle_green_breathing_keyframes },
	{ 0b1010101010101010, 60, ARRAY_LENGTH(color_cycle_green_breathing_keyframes), color_cycle_green_breathing_keyframes },

	{ 0xFFFF, 0, ARRAY_LENGTH(color_cycle_cyan_breathing_keyframes), color_cycle_cyan_breathing_keyframes },
	{ 0xFFFF, 60, ARRAY_LENGTH(color_cycle_cyan_breathing_keyframes), color_cycle_cyan_breathing_keyframes },
	{ 0b1010101010101010, 60, ARRAY_LENGTH(color_cycle_cyan_breathing_keyframes), color_cycle_cyan_breathing_keyframes },

	{ 0xFFFF, 0, ARRAY_LENGTH(color_cycle_blue_breathing_keyframes), color_cycle_blue_breathing_keyframes },
	{ 0xFFFF, 60, ARRAY_LENGTH(color_cycle_blue_breathing_keyframes), color_cycle_blue_breathing_keyframes },
	{ 0b1010101010101010, 60, ARRAY_LENGTH(color_cycle_blue_breathing_keyframes), color_cycle_blue_breathing_keyframes },

	{ 0xFFFF, 0, ARRAY_LENGTH(color_cycle_violet_breathing_keyframes), color_cycle_violet_breathing_keyframes },
	{ 0xFFFF, 60, ARRAY_LENGTH(color_cycle_violet_breathing_keyframes), color_cycle_violet_breathing_keyframes },
	{ 0b1010101010101010, 60, ARRAY_LENGTH(color_cycle_violet_breathing_keyframes), color_cycle_violet_breathing_keyframes },

	{ 0xFFFF, 0, ARRAY_LENGTH(color_cycle_pink_breathing_keyframes), color_cycle_pink_breathing_keyframes },
	{ 0xFFFF, 60, ARRAY_LENGTH(color_cycle_pink_breathing_keyframes), color_cycle_pink_breathing_keyframes },
	{ 0b1010101010101010, 60, ARRAY_LENGTH(color_cycle_pink_breathing_keyframes), color_cycle_pink_breathing_keyframes },

	{ 0xFFFF, 0, ARRAY_LENGTH(color_cycle_white_breathing_keyframes), color_cycle_white_breathing_keyframes },
	{ 0xFFFF, 60, ARRAY_LENGTH(color_cycle_white_breathing_keyframes), color_cycle_white_breathing_keyframes },
	{ 0b1010101010101010, 60, ARRAY_LENGTH(color_cycle_white_breathing_keyframes), color_cycle_white_breathing_keyframes },

	{ 0xFFFF, 0, ARRAY_LENGTH(color_cycle_magenta_blue_hb_keyframes), color_cycle_magenta_blue_hb_keyframes },
	{ 0b1010101010101010, 0, ARRAY_LENGTH(color_cycle_magenta_blue_hb_keyframes), color_cycle_magenta_blue_hb_keyframes },

	{ 0xFFFF, 0, ARRAY_LENGTH(color_cycle_green_pink_hb_keyframes), color_cycle_green_pink_hb_keyframes },
	{ 0b1010101010101010, 0, ARRAY_LENGTH(color_cycle_green_pink_hb_keyframes), color_cycle_green_pink_hb_keyframes },
};

color_cycle_parameters color_cycle_parameters_from_flash(const color_cycle_parameters *params)
{
	color_cycle_parameters value;

	value.active_pattern = pgm_read_word(&params->active_pattern);
	value.cycle_offset = pgm_read_byte(&params->cycle_offset);
	static_assert(sizeof(value.keyframes) == sizeof(uint16_t));
	value.keyframes = reinterpret_cast<const nl::strip_animator::keyframe *>(
		pgm_read_word(&params->keyframes));
	value.keyframe_count = pgm_read_byte(&params->keyframe_count);

	return value;
}

} // namespace color_cycle


} // namespace keyframes

nl::strip_animator::strip_animator() noexcept :
	ns::periodic_task(100) /* Set by the various animations. */,
	_pixels(NUMPIXELS, P_NEOP, NEO_GRB + NEO_KHZ800)
{
	ng::the_scheduler.schedule_task(*this);
}

void nl::strip_animator::setup() noexcept
{
	_pixels.begin();
}

uint8_t nl::strip_animator::_get_keyframe_index(const indice_storage_element *indices,
						uint8_t led_id) const noexcept
{
	const auto& element = indices[led_id / 2];

	return led_id & 1 ? element.odd : element.even;
}

void nl::strip_animator::_set_keyframe_index(indice_storage_element *indices,
					     uint8_t led_id,
					     uint8_t new_keyframe_index) noexcept
{
	auto& element = indices[led_id / 2];

	if (led_id & 1) {
		element.odd = new_keyframe_index;
	} else {
		element.even = new_keyframe_index;
	}
}

void nl::strip_animator::_keyframe_animation_tick(
	const scheduling::absolute_time_ms& current_time_ms) noexcept
{
	// Animation specific setup
	switch (_config.keyframed._animation) {
	case keyframed_animation::SHOOTING_STAR:
		if (_state.keyframed.shooting_star.ticks_in_position ==
		    _config.keyframed.shooting_star.ticks_before_advance) {
			_state.keyframed.shooting_star.ticks_in_position = 0;
			// Stored on 4 bits, wraps around at 15.
			_state.keyframed.shooting_star.position++;

			const auto led_interval = 16 / _config.keyframed.shooting_star.star_count;
			for (uint8_t i = 0; i < _config.keyframed.shooting_star.star_count; i++) {
				const auto position = (_state.keyframed.shooting_star.position +
						       (led_interval * i)) %
					16;

				_set_keyframe_index(
					_state.keyframed.origin_keyframe_index, position, 0);
				_set_keyframe_index(
					_state.keyframed.destination_keyframe_index, position, 0);

				_state.keyframed.ticks_since_start_of_animation[position] = 0;
				_config.keyframed.active |= 1 << position;
			}
		}

		_state.keyframed.shooting_star.ticks_in_position++;
		break;
	default:
		break;
	}

	_pixels.setBrightness(_config.keyframed.brightness);

	for (uint8_t i = 0; i < 16; i++) {
		const auto origin_keyframe_index =
			_get_keyframe_index(_state.keyframed.origin_keyframe_index, i);
		const auto destination_keyframe_index =
			_get_keyframe_index(_state.keyframed.destination_keyframe_index, i);

		const auto origin_keyframe =
			keyframe_from_flash(&_config.keyframed.keyframes[origin_keyframe_index]);
		const bool led_animation_is_active = (_config.keyframed.active >> i) & 1;

		if (!led_animation_is_active) {
			// Inactive, repeat the origin keyframe.
			_pixels.setPixelColor(i,
					      origin_keyframe.color.r(),
					      origin_keyframe.color.g(),
					      origin_keyframe.color.b());
			continue;
		}

		const auto time_since_animation_start =
			_state.keyframed.ticks_since_start_of_animation[i] * period_ms();

		if (_state.keyframed.ticks_since_start_of_animation[i] != 255) {
			// Saturate counter.
			_state.keyframed.ticks_since_start_of_animation[i]++;
		}

		// Interpolate to find the current color.
		const auto destination_keyframe = keyframe_from_flash(
			&_config.keyframed.keyframes[destination_keyframe_index]);

		// destination_keyframe.color.log(F("destination keyframe: "));

		const auto new_color = interpolate(origin_keyframe,
						   destination_keyframe,
						   uint16_t(time_since_animation_start));
		// new_color.log(F("interpolated color: "));

		_pixels.setPixelColor(i,
				      _pixels.gamma8(new_color.r()),
				      _pixels.gamma8(new_color.g()),
				      _pixels.gamma8(new_color.b()));

		// Advance keyframes if needed.
		if (time_since_animation_start < destination_keyframe.time) {
			continue;
		}

		uint8_t new_origin_keyframe_index = destination_keyframe_index;
		uint8_t new_destination_keyframe_index = destination_keyframe_index + 1;
		if (new_destination_keyframe_index >= _config.keyframed.keyframe_count) {
			// Loop back to the configured loop point. Move the current animation time
			// in the past.
			new_origin_keyframe_index = _config.keyframed.loop_point_index;
			new_destination_keyframe_index = min(new_origin_keyframe_index + 1,
							     _config.keyframed.keyframe_count - 1);
			// Round up to make sure the time isn't _before_ the origin keyframe.
			_state.keyframed.ticks_since_start_of_animation[i] =
				((keyframe_from_flash(
					  &_config.keyframed.keyframes[new_origin_keyframe_index])
					  .time +
				  (period_ms() - 1)) /
				 period_ms());
		} else {
			new_origin_keyframe_index = destination_keyframe_index;
			new_destination_keyframe_index = destination_keyframe_index + 1;
		}

		_set_keyframe_index(
			_state.keyframed.origin_keyframe_index, i, new_origin_keyframe_index);
		_set_keyframe_index(_state.keyframed.destination_keyframe_index,
				    i,
				    new_destination_keyframe_index);
	}
}

void nl::strip_animator::run(scheduling::absolute_time_ms current_time_ms) noexcept
{
	switch (_current_animation_type) {
	case animation_type::KEYFRAMED:
		_keyframe_animation_tick(current_time_ms);
		break;
	default:
		break;
	}

	// Send the updated pixel colors to the hardware.
	_pixels.show();
}

nl::strip_animator::led_color nl::strip_animator::_color(uint8_t led_id) const noexcept
{
	return led_color(&_pixels.getPixels()[led_id * 3]);
}

void nl::strip_animator::set_idle_animation(uint8_t id) noexcept
{
	/*
	 * This looks pretty bad, but the goal is to alternate between animations
	 * of each type as 'id' increases.
	 */
	const auto shooting_star_animations_count = ARRAY_LENGTH(keyframes::shooting_star::params);
	const auto color_cycle_animations_count = ARRAY_LENGTH(keyframes::color_cycle::params);

	id = id % (shooting_star_animations_count + color_cycle_animations_count);

	if (id / 2 < shooting_star_animations_count && id / 2 < color_cycle_animations_count) {
		if (id % 2) {
			const auto cc_params =
				keyframes::color_cycle::color_cycle_parameters_from_flash(
					&keyframes::color_cycle::params[id / 2]);

			_set_keyframed_cycle_animation(cc_params.keyframes,
						       cc_params.keyframe_count,
						       1,
						       cc_params.active_pattern,
						       cc_params.cycle_offset,
						       20);
			return;
		} else {
			const auto ss_params =
				keyframes::shooting_star::shooting_star_parameters_from_flash(
					&keyframes::shooting_star::params[id / 2]);

			_set_shooting_star_animation(ss_params.shooting_star_count,
						     ss_params.delay_advance_ms,
						     ss_params.keyframes,
						     ss_params.keyframe_count);
			return;
		}
	}

	// Handle arrays being of different lengths.
	if (shooting_star_animations_count > color_cycle_animations_count) {
		id -= color_cycle_animations_count;
		const auto ss_params =
			keyframes::shooting_star::shooting_star_parameters_from_flash(
				&keyframes::shooting_star::params[id]);

		_set_shooting_star_animation(ss_params.shooting_star_count,
					     ss_params.delay_advance_ms,
					     ss_params.keyframes,
					     ss_params.keyframe_count);
		return;
	} else {
		id -= shooting_star_animations_count;
		const auto cc_params = keyframes::color_cycle::color_cycle_parameters_from_flash(
			&keyframes::color_cycle::params[id]);

		_set_keyframed_cycle_animation(cc_params.keyframes,
					       cc_params.keyframe_count,
					       1,
					       cc_params.active_pattern,
					       cc_params.cycle_offset,
					       20);
		return;
	}
}

void nl::strip_animator::_reset_keyframed_animation_state() noexcept
{
	memset(&_state.keyframed, 0, sizeof(_state.keyframed));
}

void nl::strip_animator::set_red_to_green_led_progress_bar(uint8_t active_led_count) noexcept
{
	const bool is_current_animation = _current_animation_type == animation_type::KEYFRAMED &&
		_config.keyframed._animation == keyframed_animation::PROGRESS_BAR;

	if (!is_current_animation) {
		period_ms(40);

		// Setup animation parameters.
		_current_animation_type = animation_type::KEYFRAMED;
		_config.keyframed._animation = keyframed_animation::PROGRESS_BAR;
		_config.keyframed.active = 0;
		_config.keyframed.keyframe_count = ARRAY_LENGTH(keyframes::red_to_green_progress_bar_keyframe_template);
		_config.keyframed.keyframes = keyframes::red_to_green_progress_bar_keyframe_template;
		_config.keyframed.loop_point_index = 2;
		_config.keyframed.brightness = 120;

		// Clear its state.
		_reset_keyframed_animation_state();
	}

	for (uint8_t i = 0; i < active_led_count; i++) {
		_config.keyframed.active |= (1 << i);
	}
}

void nl::strip_animator::set_pairing_completed_animation(
	nl::strip_animator::pairing_completed_animation_type animation_type) noexcept
{
	set_show_level_animation(animation_type, 0xFF, true);
}

void nl::strip_animator::set_show_level_animation(
	nl::strip_animator::pairing_completed_animation_type animation_type,
	uint8_t level,
	bool set_lower_bar_on) noexcept
{
	period_ms(40);

	uint8_t cycle_offset = 0;
	uint16_t active_mask = 0;

	for (uint8_t i = 0; i < 8; i++) {
		// LED at bit number one is the left-most, so we need to "invert" the level pattern.
		const auto value_bit = (level >> i) & 1;
		active_mask |= value_bit << (7 - i);
	}

	const keyframe *keyframes = nullptr;
	uint8_t keyframe_count = 0;

	if (animation_type == pairing_completed_animation_type::HAPPY_CLOWN_BARF) {
		keyframe_count = ARRAY_LENGTH(keyframes::happy_clown_barf_keyframes);
		keyframes = keyframes::happy_clown_barf_keyframes;
		// Apply a slight offset between LEDs to achieve a "sparkle" effect.
		cycle_offset = 10;
	} else {
		keyframe_count = ARRAY_LENGTH(keyframes::no_new_friends_keyframes);
		keyframes = keyframes::no_new_friends_keyframes;
	}

	if (set_lower_bar_on) {
		active_mask |= 0xFF00;
	}

	_set_keyframed_cycle_animation(keyframes, keyframe_count, 1, active_mask, cycle_offset, 40);
}

void nl::strip_animator::_set_shooting_star_animation(uint8_t star_count,
						     unsigned int advance_interval_ms,
						     const keyframe *keyframes,
						     uint8_t keyframe_count) noexcept
{
	period_ms(20);
	_current_animation_type = animation_type::KEYFRAMED;
	_config.keyframed._animation = keyframed_animation::SHOOTING_STAR;
	_config.keyframed.active = 0;
	_reset_keyframed_animation_state();
	_config.keyframed.keyframe_count = keyframe_count;
	_config.keyframed.keyframes = keyframes;

	_config.keyframed.loop_point_index = 0;
	_config.keyframed.brightness = 50;
	_config.keyframed.shooting_star.ticks_before_advance = advance_interval_ms / period_ms();
	_config.keyframed.shooting_star.star_count = star_count;
}

void nl::strip_animator::_set_keyframed_cycle_animation(const keyframe *keyframe,
							uint8_t keyframe_count,
							uint8_t loop_point_index,
							uint16_t active_mask,
							uint8_t cycle_offset_between_frames,
							uint8_t refresh_rate) noexcept
{
	period_ms(refresh_rate);

	// Setup animation parameters.
	_current_animation_type = animation_type::KEYFRAMED;
	_config.keyframed._animation = keyframed_animation::CYCLE;
	_config.keyframed.active = active_mask;

	_reset_keyframed_animation_state();

	_config.keyframed.keyframe_count = keyframe_count;
	_config.keyframed.keyframes = keyframe;

	// Apply an offset between LEDs to achieve a "sparkle" effect.
	for (uint8_t i = 0; i < 16; i++) {
		_state.keyframed.ticks_since_start_of_animation[i] =
			(i * cycle_offset_between_frames) %
			(keyframe_from_flash(
				 &_config.keyframed.keyframes[_config.keyframed.keyframe_count - 1])
				 .time /
			 period_ms());
	}

	_config.keyframed.loop_point_index = loop_point_index;
	_config.keyframed.brightness = 50;
}
