nsec/badge-conf-2023/(commit log)

2023-02-24 Add a .clang-tidy file and fix warnings
    [main.cpp]
2023-02-26 Add scheduler
    Adds a minimal scheduling util class that allows periodic and "one-shot"
    tasks to be scheduled. The main loop simply invokes "tick()" and
    `scheduler` will run any task that has reached its deadline.
    This simplifies the main loop quite a bit and makes it possible to
    identify the next task to run instead of open-coding time checks.
    Hopefully we can use that to sleep when there is nothing to do, saving a
    bit of power in the process.
    A native_tests platform is added to test the scheduling library in a
    regular development environment. I am not sure this part is done in the
    best way though.
2023-02-26 Add a badge class to manage the global state
    The badge class managed the current logical state of the badge.
    Currently it mostly hides things that were global, but it will
    gradually evolve to represent the "application logic" that drives
    the display, leds, and communication components.
    Follow-up changes move the rest of the main loop to become task-based
    which are ran by the scheduler and scheduled by the badge and its
    various subsystems.
2023-02-26 Make LED animations and button polling task-based
    The LED strip animations are now run as part of a periodic task
    (see strip_animator.cpp) with a variable period.
    To replicate the existing functionality of increasing/decreasing levels
    when the up/down buttons are pressed, a "button watcher" task is added.
    This task samples the states of buttons periodically
    (every 10ms right now, configurable in config.hpp) to debounce the six
    buttons (up, down, left, right, ok, cancel).
    The "raw" button readings are converted into "button up", "button down",
    and "button down repeat" events that other components can listen for.
    These two components are grouped under a "badge" class. This class
    represents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
2023-02-26 Set social level initial value to 1 instead of 0
    Social levels are clamped to [1, 200]. The current initial level being 0
    causes the animation to appear glitchy when pressing 'up' the first
    time (it just restarts the animation).
    [badge.cpp]
2023-03-02 Remove stale comment about button watcher states
    At some point button watcher states and "ticks in state" were fused in
    the same byte. However, with the current implementation there are too
    many possible states and ticks counted for key repeats to fit in 8 bits.
    Simply transition _state to the proper state enum class and eliminate
    the stale comment.
2023-03-02 Remove button debugging output
2023-03-02 Forward button events to the focused screen
2023-03-19 Fix: don't assume current text color when rendering idle screen
    A previously rendered screen may leave the current text color inverted,
    changing the behavior of the idle screen when it is rendered after
    regaining focus.
2023-03-20 Add a menu screen
    The menu screen is a menu template that can be updated with various set
    of choices. This allows sub-menus to be implemented by updating the
    current choices of the menu.
    Currently, the badge sets a place holder set of choices to demonstrate
    the rendering features and the overall look and feel. The actions for
    the various choices consist in logging the name of the choice.
    To try it, press 'Cancel' to exit the 'idle' screen.
    The place holder demoes the following features:
    - scrolling,
    - drawing a "scrollbar" when needed,
    - highlight current selection,
    - action executed when pressing 'Ok' or the right arrow,
    - left arrow goes "back" to the idle screen.
    Signed-off-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
2023-04-01 Add a string_property_editor class to edit the user's name
    The string property editor is used to allow the user to edit any string.
    For the moment, it is used to edit the user's name. It allows the
    characters: [A-Z], [a-z], ' ', and '-'.
    The up/down arrows allow you to change the current letter (rendered with
    negative colors) and the left/right arrows allow you to change the
    current letter.
    The 'X' button can be used to delete characters. To leave the menu, hold
    the 'okay' (✅) button.
2023-04-21 Fix setting the fuses of a blank atmega328 with the USBasp
    The default configuration of a factory-fresh ATmega328 is to run at 1MHz
    using internal 8MHz clock and x8 prescaler. This is too slow for the
    default speed of the USBasp, use a slower bit clock of 10us to set the
    fuses.
    Also cleanup the upload configuration in platformio.ini.
2023-04-27 Adafruit_SSD1306: make the use of a static framebuffer possible
    The dynamic allocation of the framebuffer by Adafruit_SSD1306 makes it
    hard to track the RAM usage during development.
    These changes are minimal, but I don't really see a drawback except that
    the size of the buffer to provide to `begin` can easily be
    miscalculated.
2023-04-27 Initialize Adafruit_SSD1306 to use a static framebuffer
    Experimentally, this leaves us with around ~140 bytes of RAM before
    stuff start to act wonky considering our current stack usage patterns.
2023-04-27 Free a bit of RAM for future rainy days
    Shorten the maximal allowed name length to 32 characters. Remove some
    data pointers from focus release notifiers since the badge is global
    anyhow.
    [badge.cpp, badge.hpp, config.hpp]
2023-04-27 Clean-up: coding style fix
    [badge.hpp]
2023-04-27 Renderer: periodically output frame render time
2023-04-27 Scroll screen: draw frame in multiple passes
    Since rendering a full framebuffer of text takes around 35ms, the
    rendering task blocks the badge for a long time on every frame draw.
    This makes the buttons and some animations feel sluggish. To work-around
    the problem, the scroll screen rendering is split into 4 states. This
    ensures that render calls take around 4ms, maintaining a responsive
    feel.
    [config.hpp, renderer.cpp]
2023-05-05 Network: implement the basis of the networking protocol
    The SoftwareSerial library only allows listening on one of the two
    SoftwareSerial instances at a time. Given this limitation, the network
    protocol between the badges resembles the token-ring networks of times
    long passed.
    The network protocol (wire protocol) defines the concept of a wave front
    direction: it is the direction in which the messages are currently
    flowing along the chain of badges.
    When the network connections are established, the badges can broadcast
    on a turn-by-turn basis. The wave front directions reverses when it
    reaches the bounds of the chain of badges.
    When a badge broadcasts, it sends its message(s) and ends its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
    [badge.cpp, badge.hpp, config.hpp, main.cpp, network_handler.cpp]
2023-05-05 Network: refactor into a proper protocol state machine
    Refactoring the network code into a proper state machine will make it
    easier to implement the retransmission logic in a follow-up commit.
    Retransmits are sometimes necessary since other tasks (the LED strip
    animation task, for one) periodically disable the interrupts which
    causes the SoftwareSerial to miss the beginning of some transmissions.
2023-05-05 Network: implement a retransmit mechanism
    Retransmit messages when magic or checksum checks fail.
    [badge.cpp, config.hpp, network_handler.cpp]
2023-05-06 Accept any message when expecting OK
    At this stage of the protocol, that's the only valid message. While the
    network link is fairly robust at this point, most failures occur on this
    validation, so we take the bet of excluding this check.
    [network_handler.cpp]
2023-05-07 LED strip animator: implement a keyframe based animation mechanism
    LED animations can now be defined as a series of keyframes, supporting
    offsets between leds, looping points, active/inactive LEDs.
    I am still working on storing the keyframes in flash rather than RAM,
    but the progress bar currently uses this new animation mechanism.
2023-05-07 Network: use the global badge variable instead of callbacks
    Callbacks consume valuable RAM and we're in a pretty bad shortage.
    [badge.cpp, badge.hpp, network_handler.cpp]
2023-05-07 Fix: network: don't assume app messages have a payload
    Some app messages don't need a payload; we can't rely on the payload
    size to know if a message is pending.
    [network_handler.cpp]
2023-05-07 Network: remove error logging
    [network_handler.cpp]
2023-05-08 Screen: share the behaviour of exiting on cancel button press
    This reduces the code size a bit yet again.
2023-05-09 LEDs: store animation keyframes in flash memory
    In order to store the keyframes in flash memory, the constructors of the
    objects have to be made constexpr. We also need a loader since "naively"
    loading the keyframes will use the wrong address space.
    [strip_animator.cpp]
2023-05-10 Remove SPI support from vendored SSD1306 lib
    This saves 1028 precious bytes from the flash.
2023-05-10 Vendor ArduinoUniqueID to save a few bytes
2023-05-10 Add board definition for prod
2023-05-11 LED animator: load keyframe timestamp from flash
    The origin keyframe's time was read directly, which caused flickering
    since that address is not in RAM.
    The division is also rounded-up to make the animation smoother in cases
    where a clean loop is defined.
2023-05-11 LED animator: gamma-correct colors
    Using gamma correction makes the colors appear less "washed-out",
    correcting for non-linear perceptual brightness changes.
    [strip_animator.cpp]
2023-05-11 Show pairing and LED animations when a pairing completes
2023-05-12 Wire up the factory reset option
    The user can factory reset the badge by navigating to the "Factory
    reset" menu choice and holding "ok" as prompted on the screen.
    [badge.cpp, badge.hpp]
2023-05-12 Fix: clear the ID buffer on factory reset
    [badge.cpp]
2023-05-12 Change the "no new badges detected" LED animation to flashing red lights
2023-05-12 Print only the last 4 bytes of the unique ID
2023-05-12 Clear debug LED on disconnect
2023-05-13 Lower the display refresh rate to smoothen LED animations
2023-05-13 Turn off the lower LED bar when showing binary score
    At the same time, the initialization of a "cycle" animation (that the
    pairing result animations are based-on) is extracted to a stand-alone
    function for future re-use.
2023-05-13 Tweak the pairing complete messages shown on screen
    Changes:
    - The word "discovered" is dropped to shorten the message
    - Smileys are eliminated as they look horrible with the current font
    - Zero-quantities are pluralized in English (TIL) (e.g. "I have one
    beer left" vs "I have no beers left").
    [badge.cpp]
2023-05-13 Add shortcut to badge info screen
    Holding the UP button on the scroll screen will open the badge info
    screen.
    [badge.cpp, badge.hpp]
2023-05-26 Added hardware files (schematic/PCB)
    [BOM.xlsx, bom.xlsx, confBadgeV1.brd, confBadgeV1.sch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]
