nsec/badge-conf-2023/(notices)

Notices in the files:
parts and their libraries:
microbuilder: This work is placed in the public domain, and may be freely used for commercial and non-commercial work with the following conditions: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
401-2016-2-ND: COPYRIGHT: Copyright (C) 2022 Ultra Librarian. All rights reserved.
